0sirys/Juan_Pimentel_Electiva_2026_C2/CAD/Ejercicio_2.FCStd

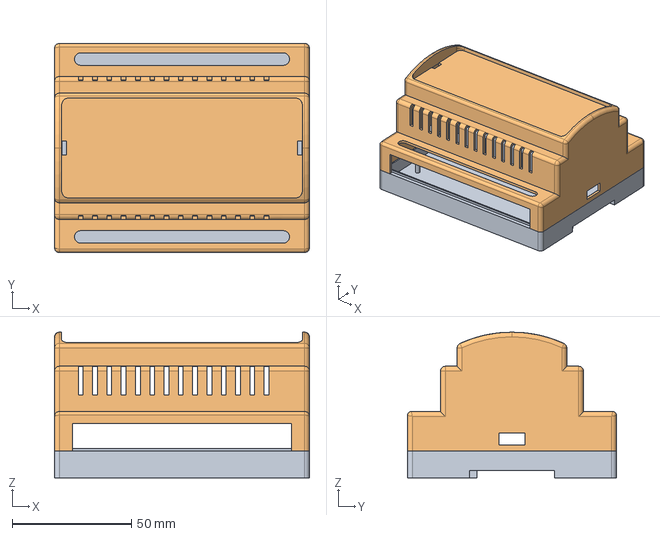
[picture p1: CAD file, 2026-06-18]
CAD/Ejercicio_2.FCStd
107.0 x 87.7 x 61.1 mm
