0sirys/Juan_Pimentel_Electiva_2026_C2/CAD/Ejercicio_1.FCStd

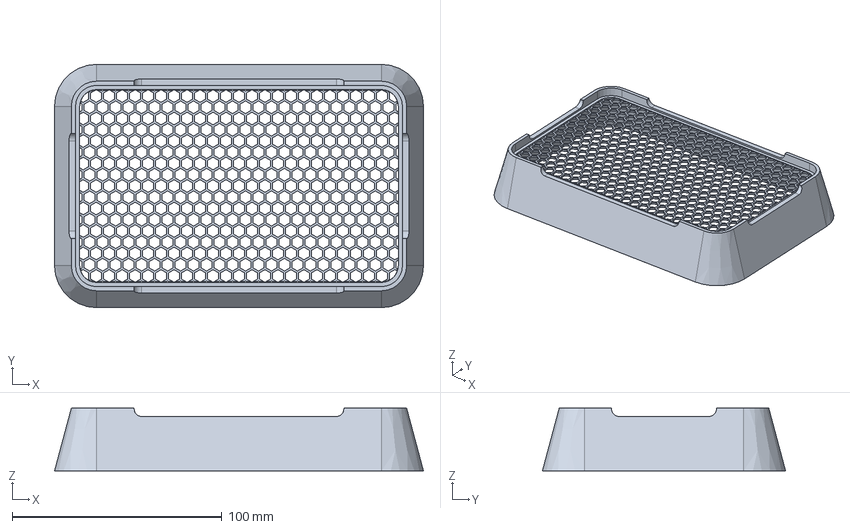
[picture p2: CAD file, 2026-06-11]
CAD/Ejercicio_1.FCStd
176.1 x 116.1 x 30.0 mm
