0sirys/Juan_Pimentel_Electiva_2026_C2/PCB/PLC4UNI/PLC4UNI-GC1.pdf

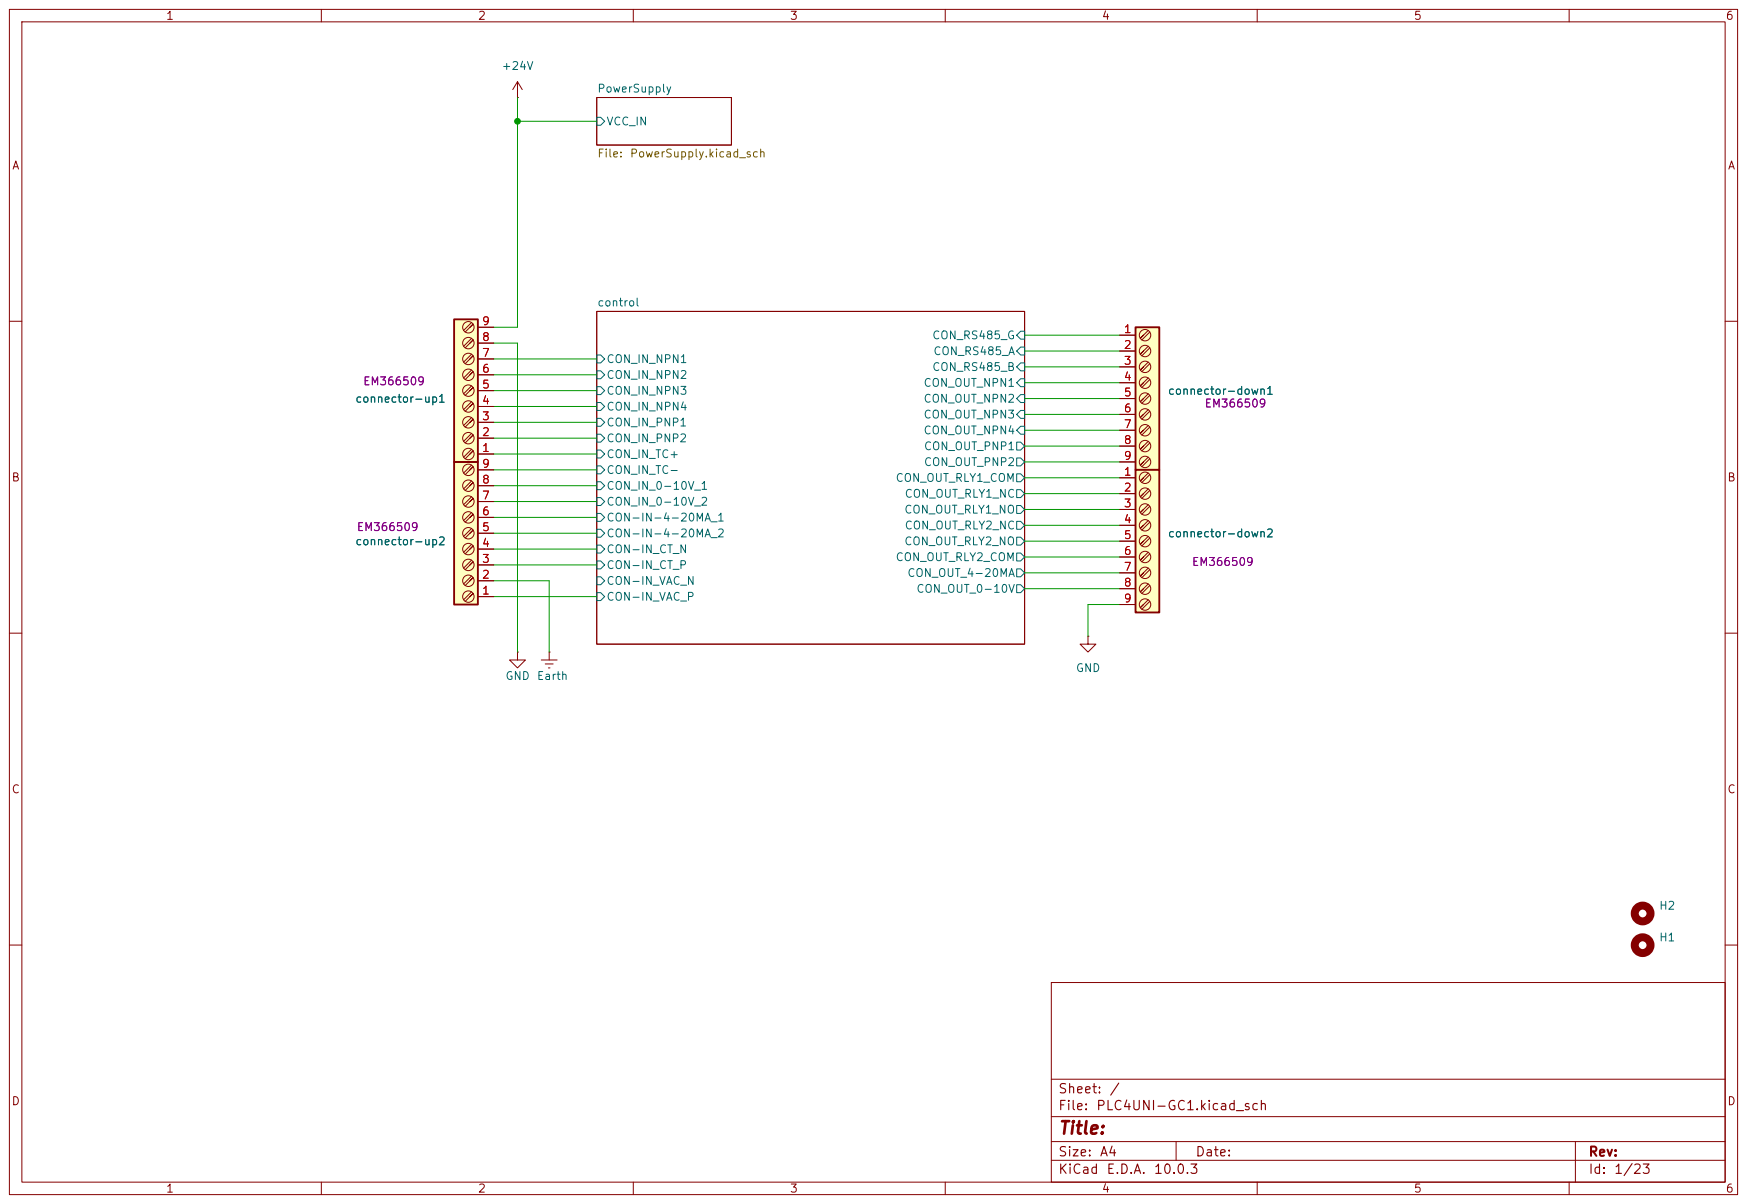
[picture p3: page 1]

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
Size: A4 | Rev:
KiCad E.D.A. 10.0.3 | Id: 1/23

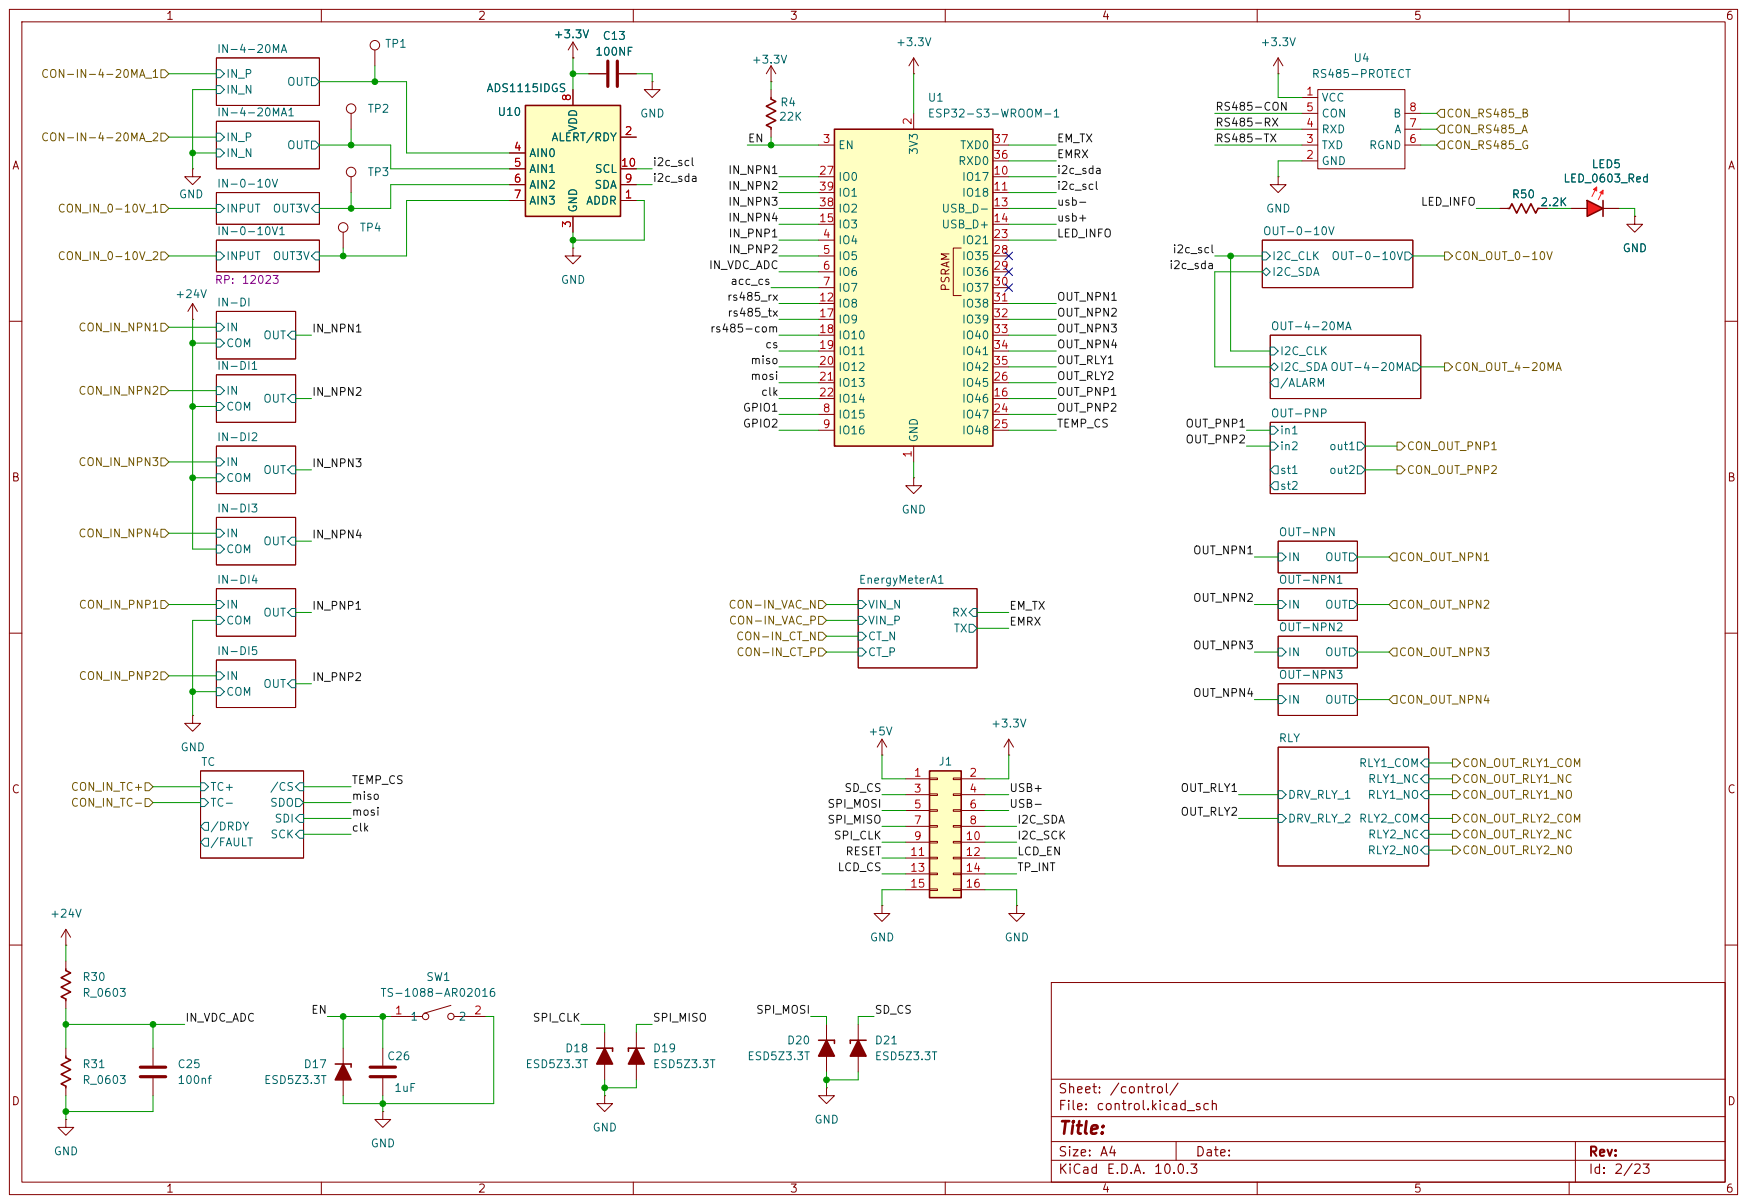
[picture p4: page 2]

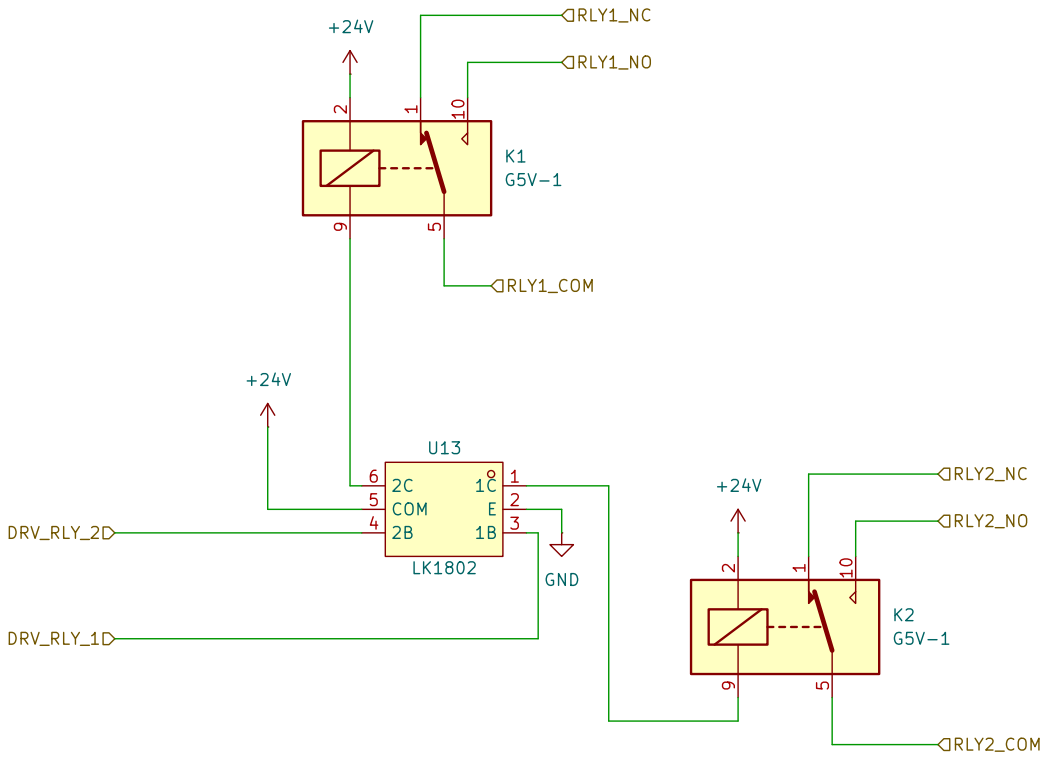
[picture p5: page 3]

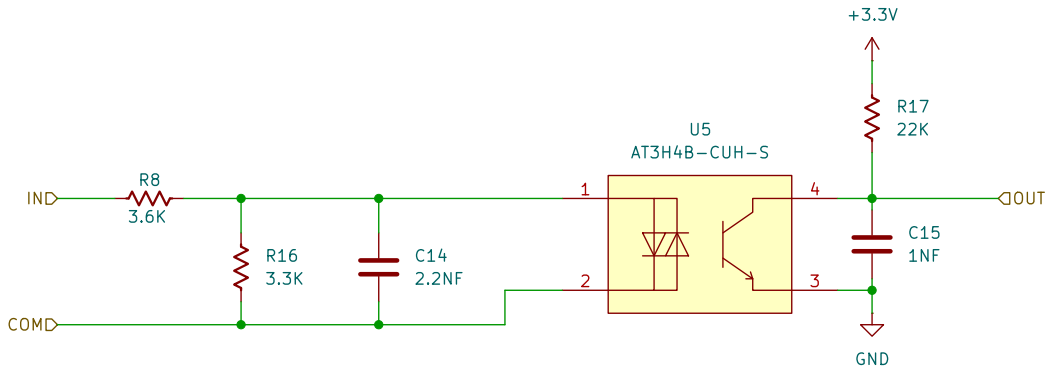
[picture p6: page 4]

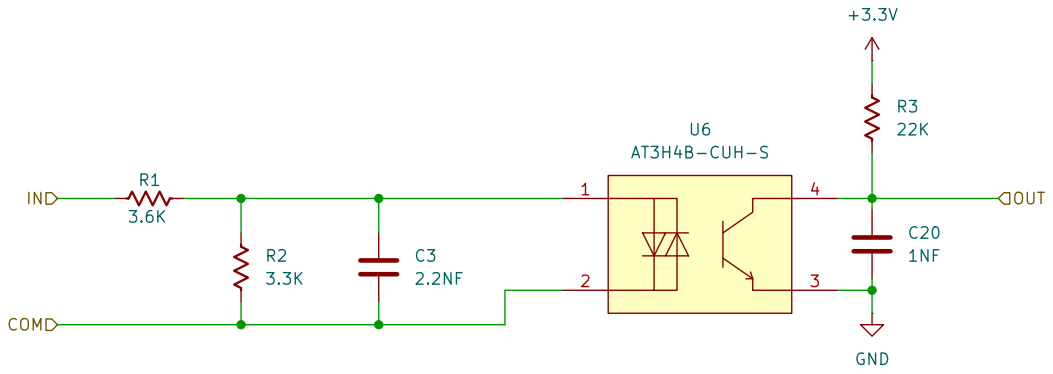
[picture p7: page 5]

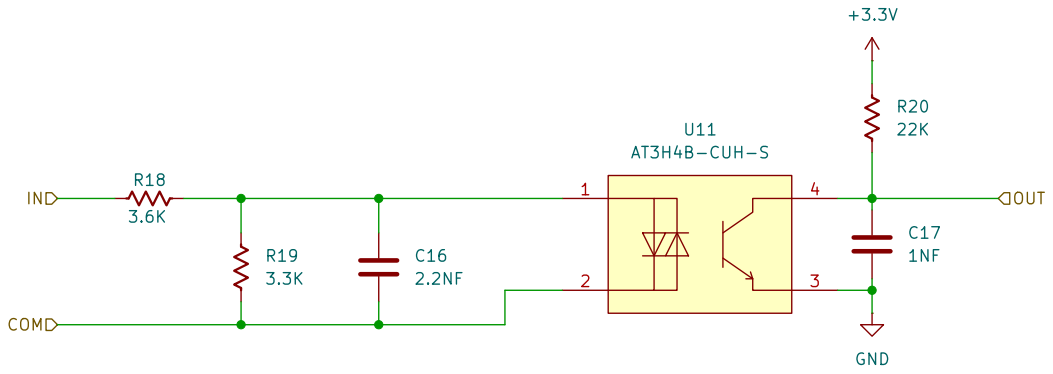
[picture p8: page 6]

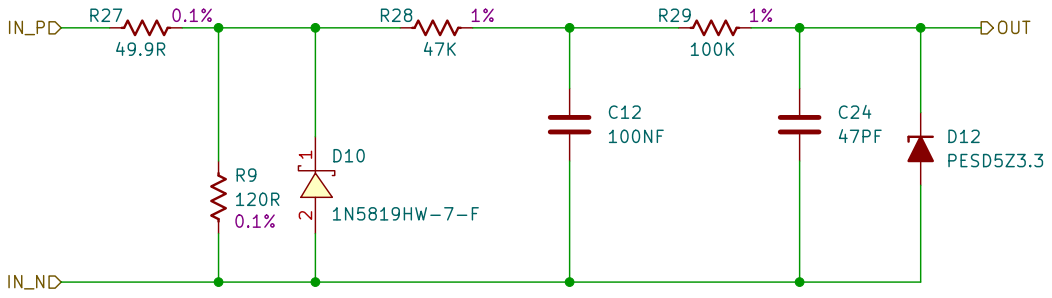
[picture p9: page 7]

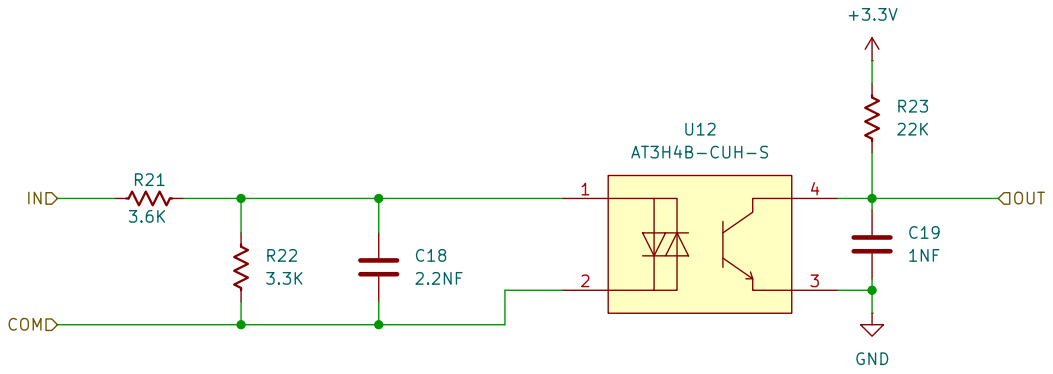
[picture p10: page 8]

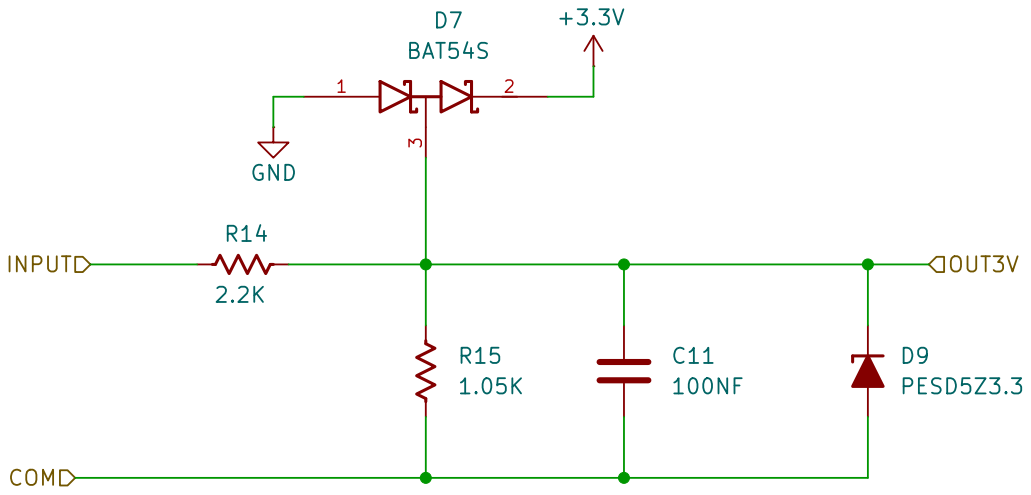
[picture p11: page 9]

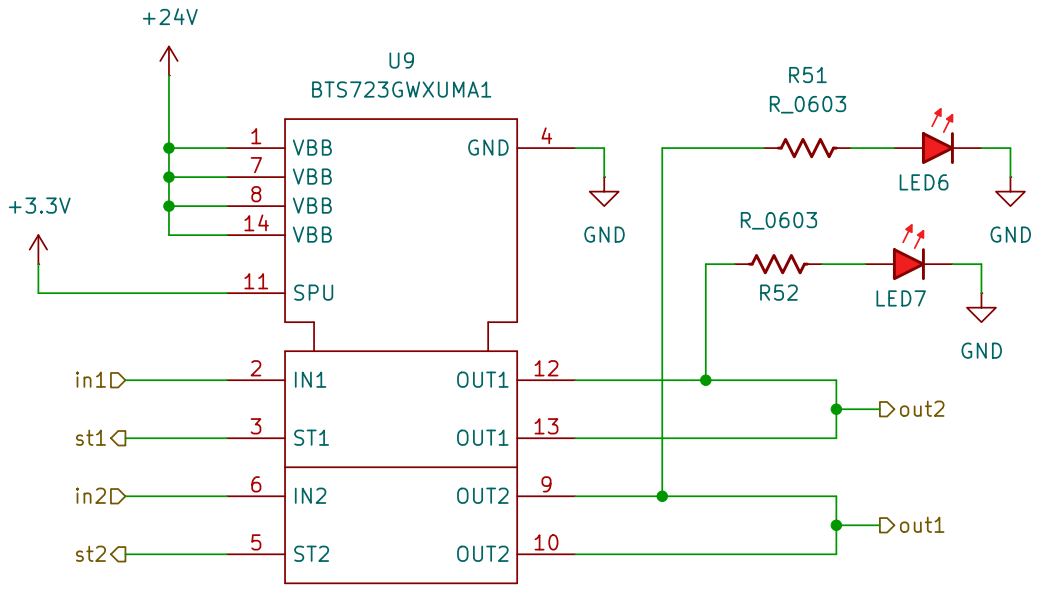
[picture p12: page 10]

Sheet: /control/OUT-PNP/
File: OUT-PNP.kicad_sch
Title:

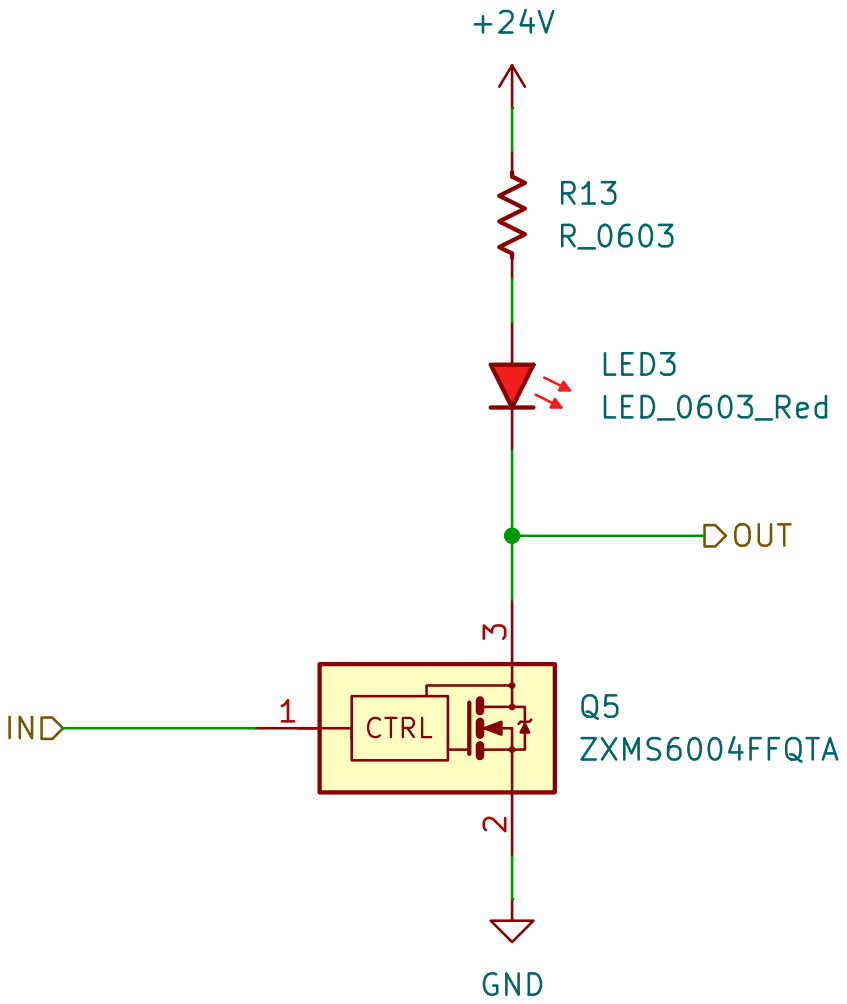
[picture p13: page 11]

Sheet: /control/OUT-NPN/
File: OUT-NPN.kicad_sch
Title:

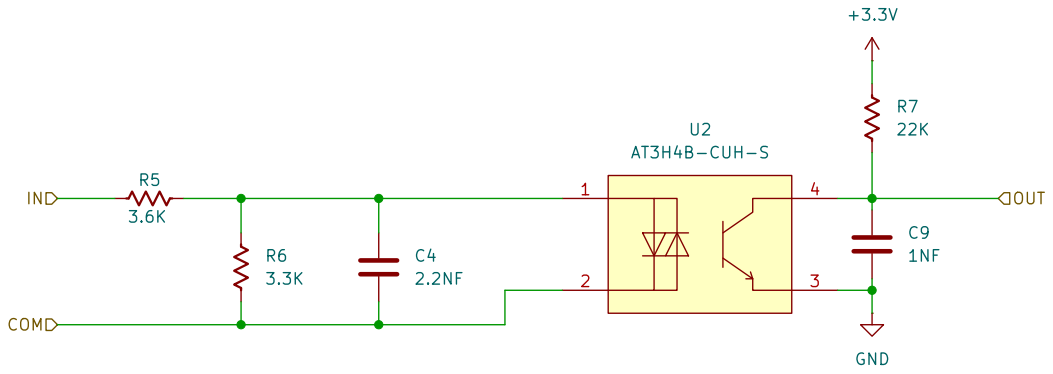
[picture p14: page 12]

Sheet: /control/IN-DI/
File: IN-DI.kicad_sch
Title:

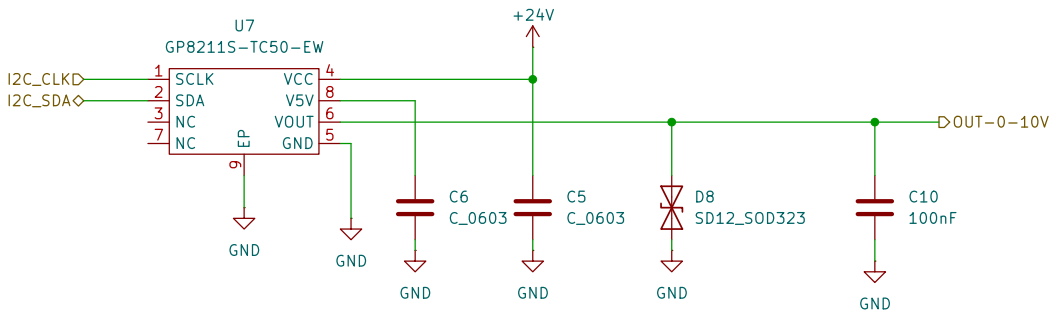
[picture p15: page 13]

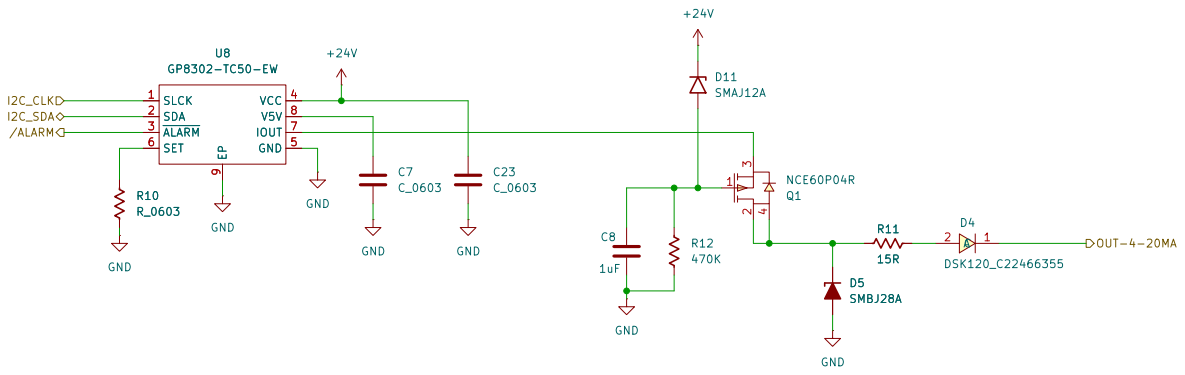
[picture p16: page 14]

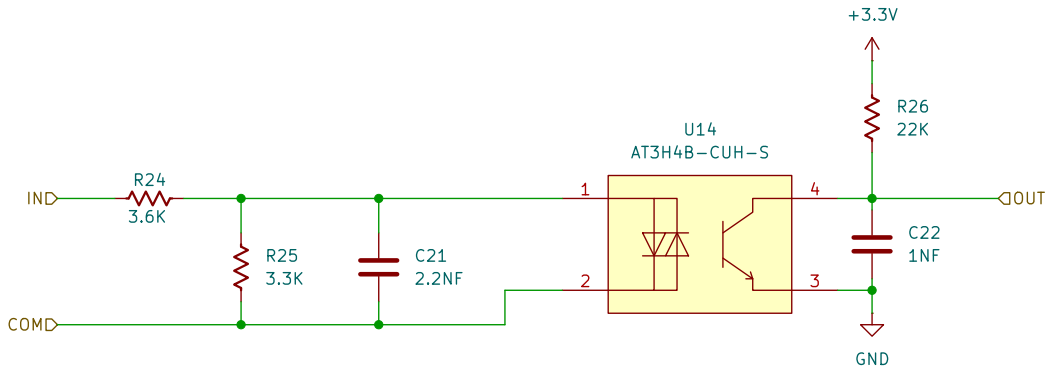
[picture p17: page 15]

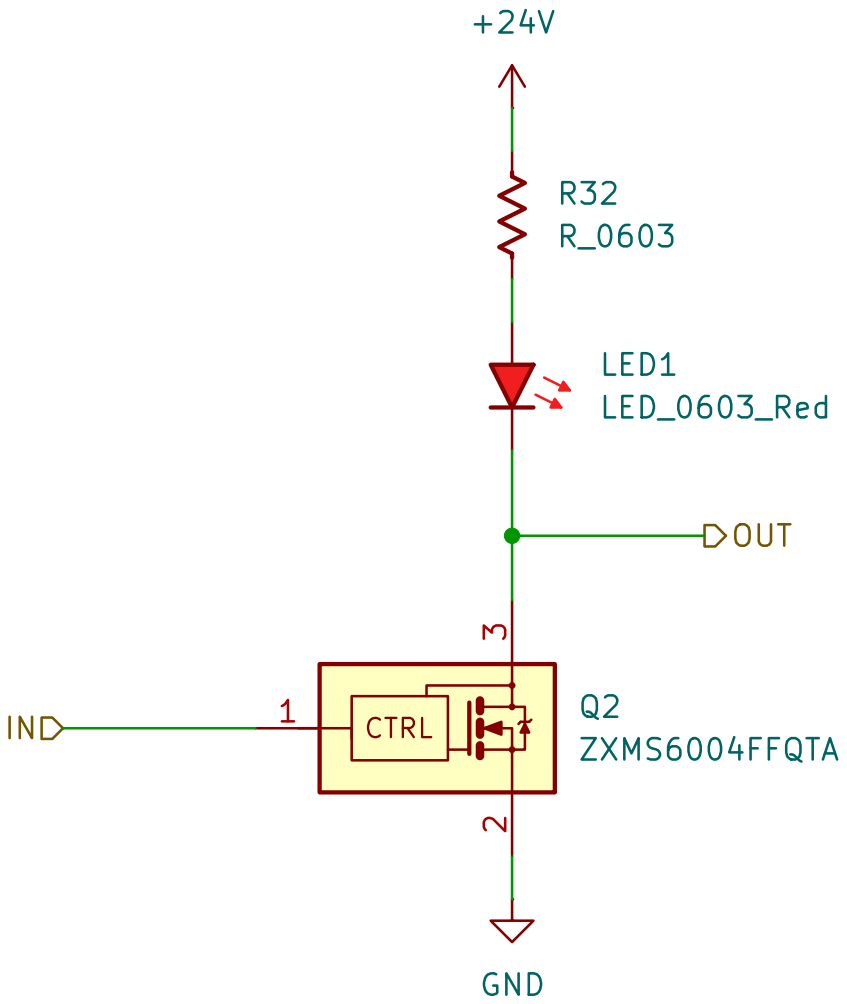
[picture p18: page 16]

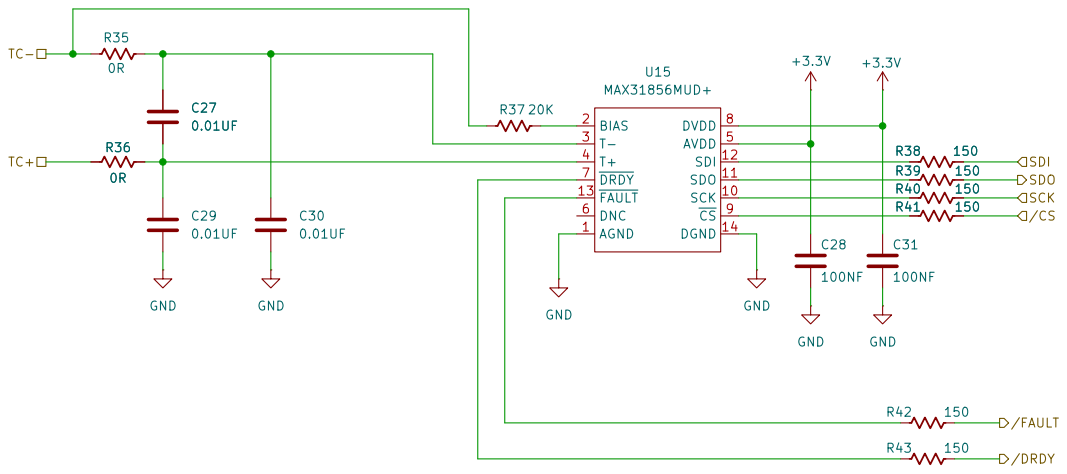
[picture p19: page 17]

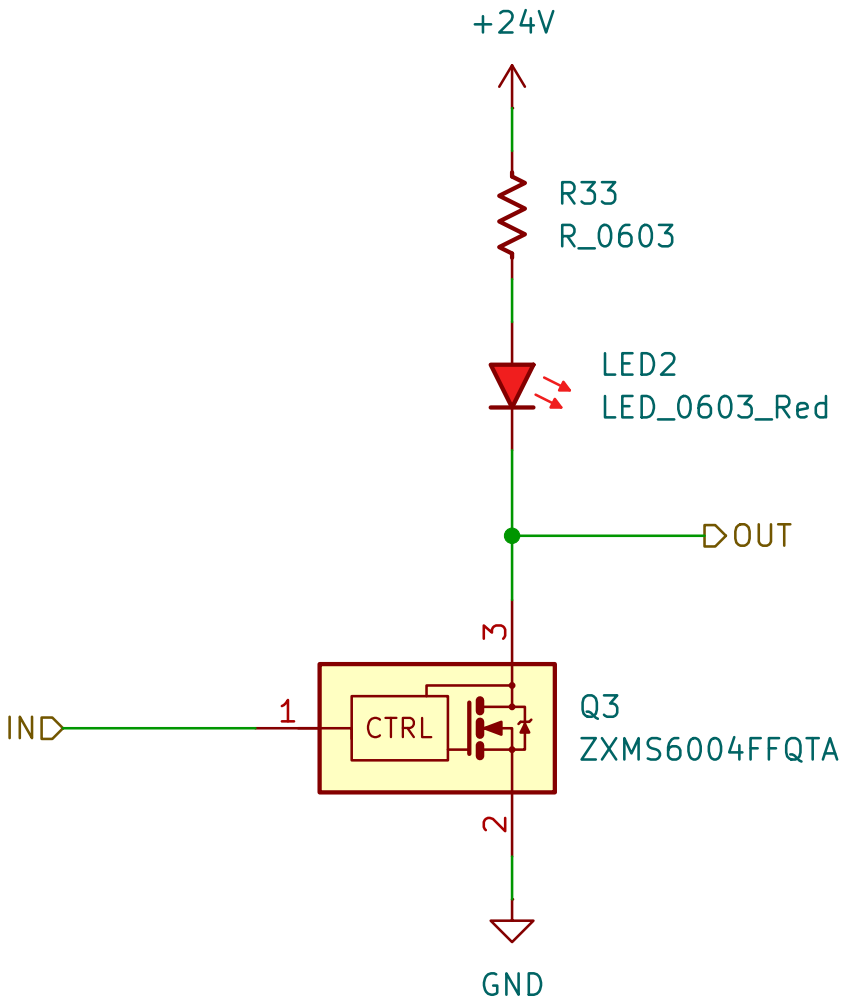
[picture p20: page 18]

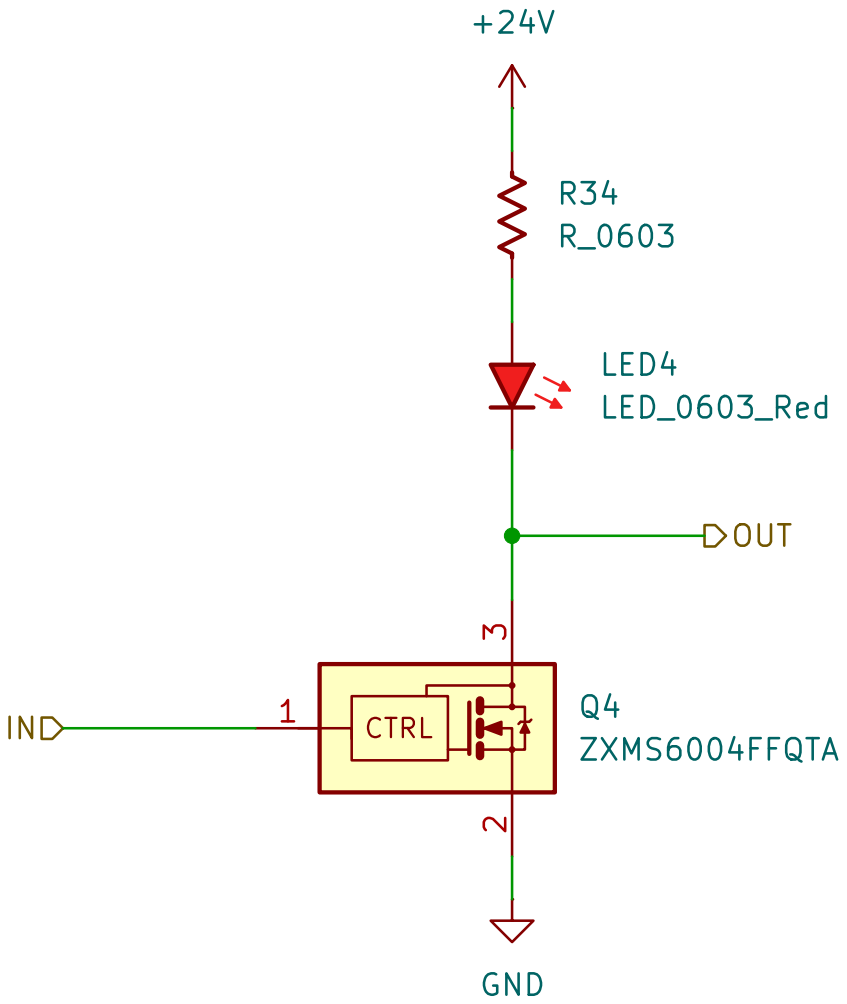
[picture p21: page 19]

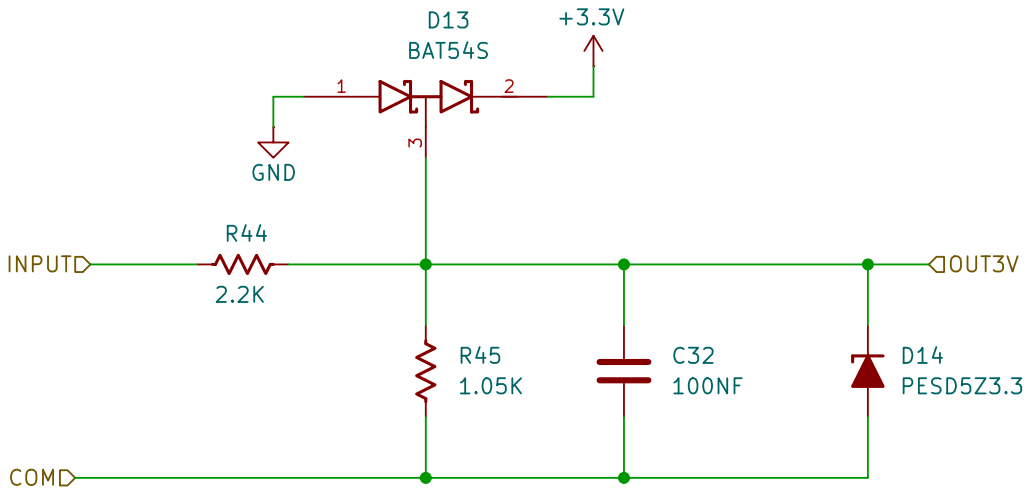
[picture p22: page 20]

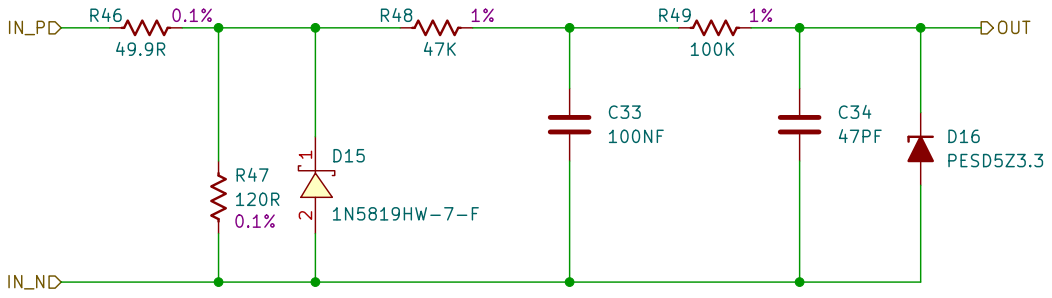
[picture p23: page 21]

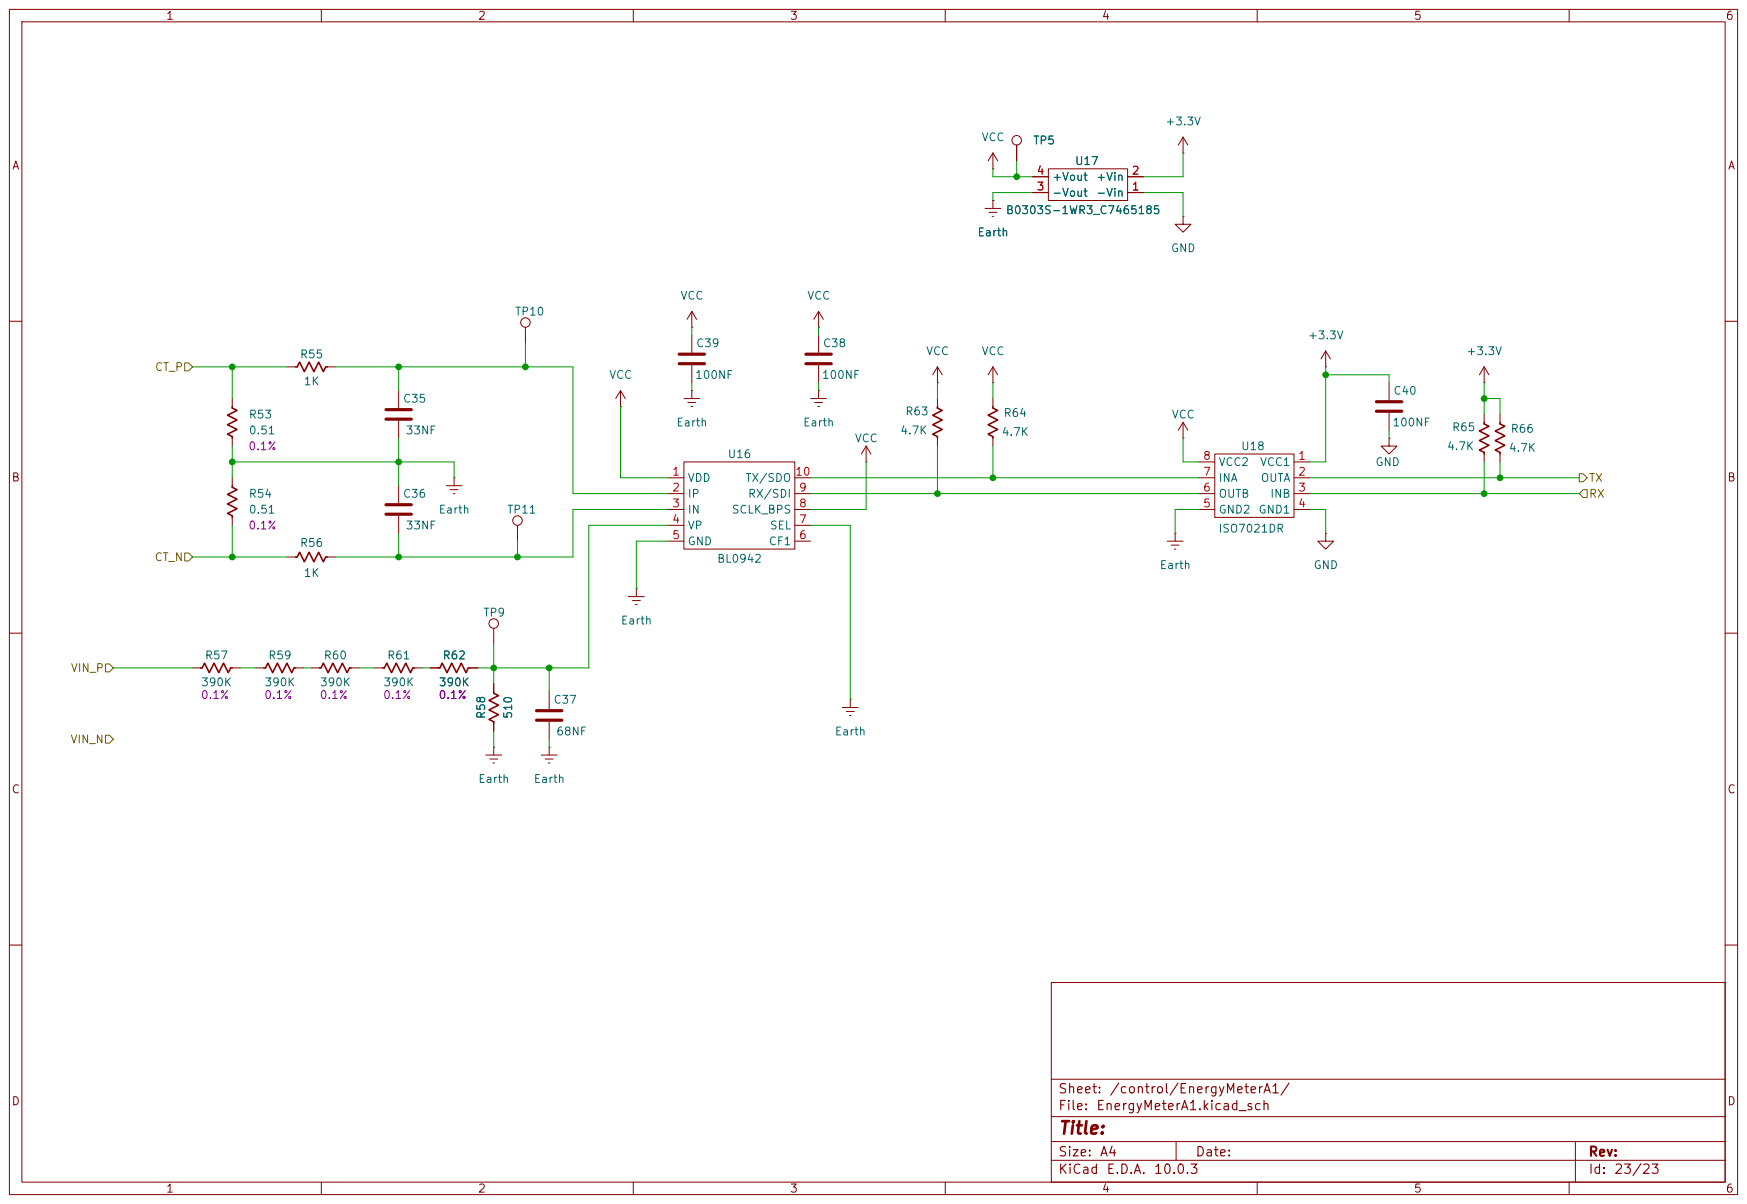
[picture p24: page 22]

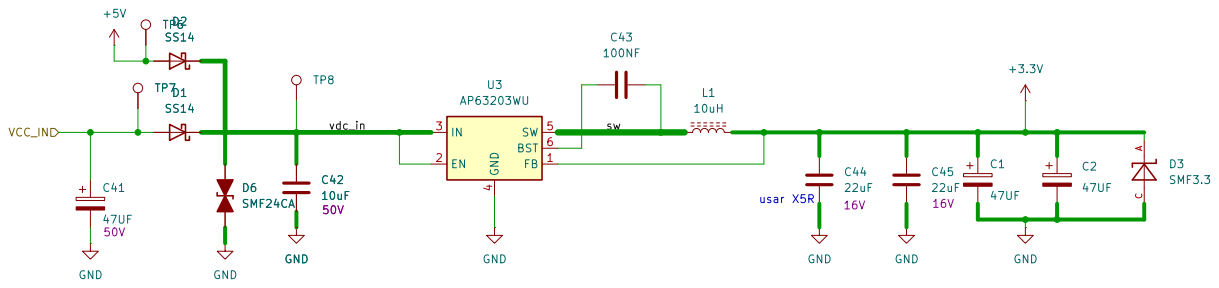
[picture p25: page 23]
