0sirys/Juan_Pimentel_Electiva_2026_C2/PCB/MEZANINI/PLC4UNI_MEZANINI/PLC4UNI_MEZANINI.kicad_pcb

## KiCad design PCB/MEZANINI/PLC4UNI_MEZANINI/PLC4UNI_MEZANINI.kicad_pcb (2026-08-13)

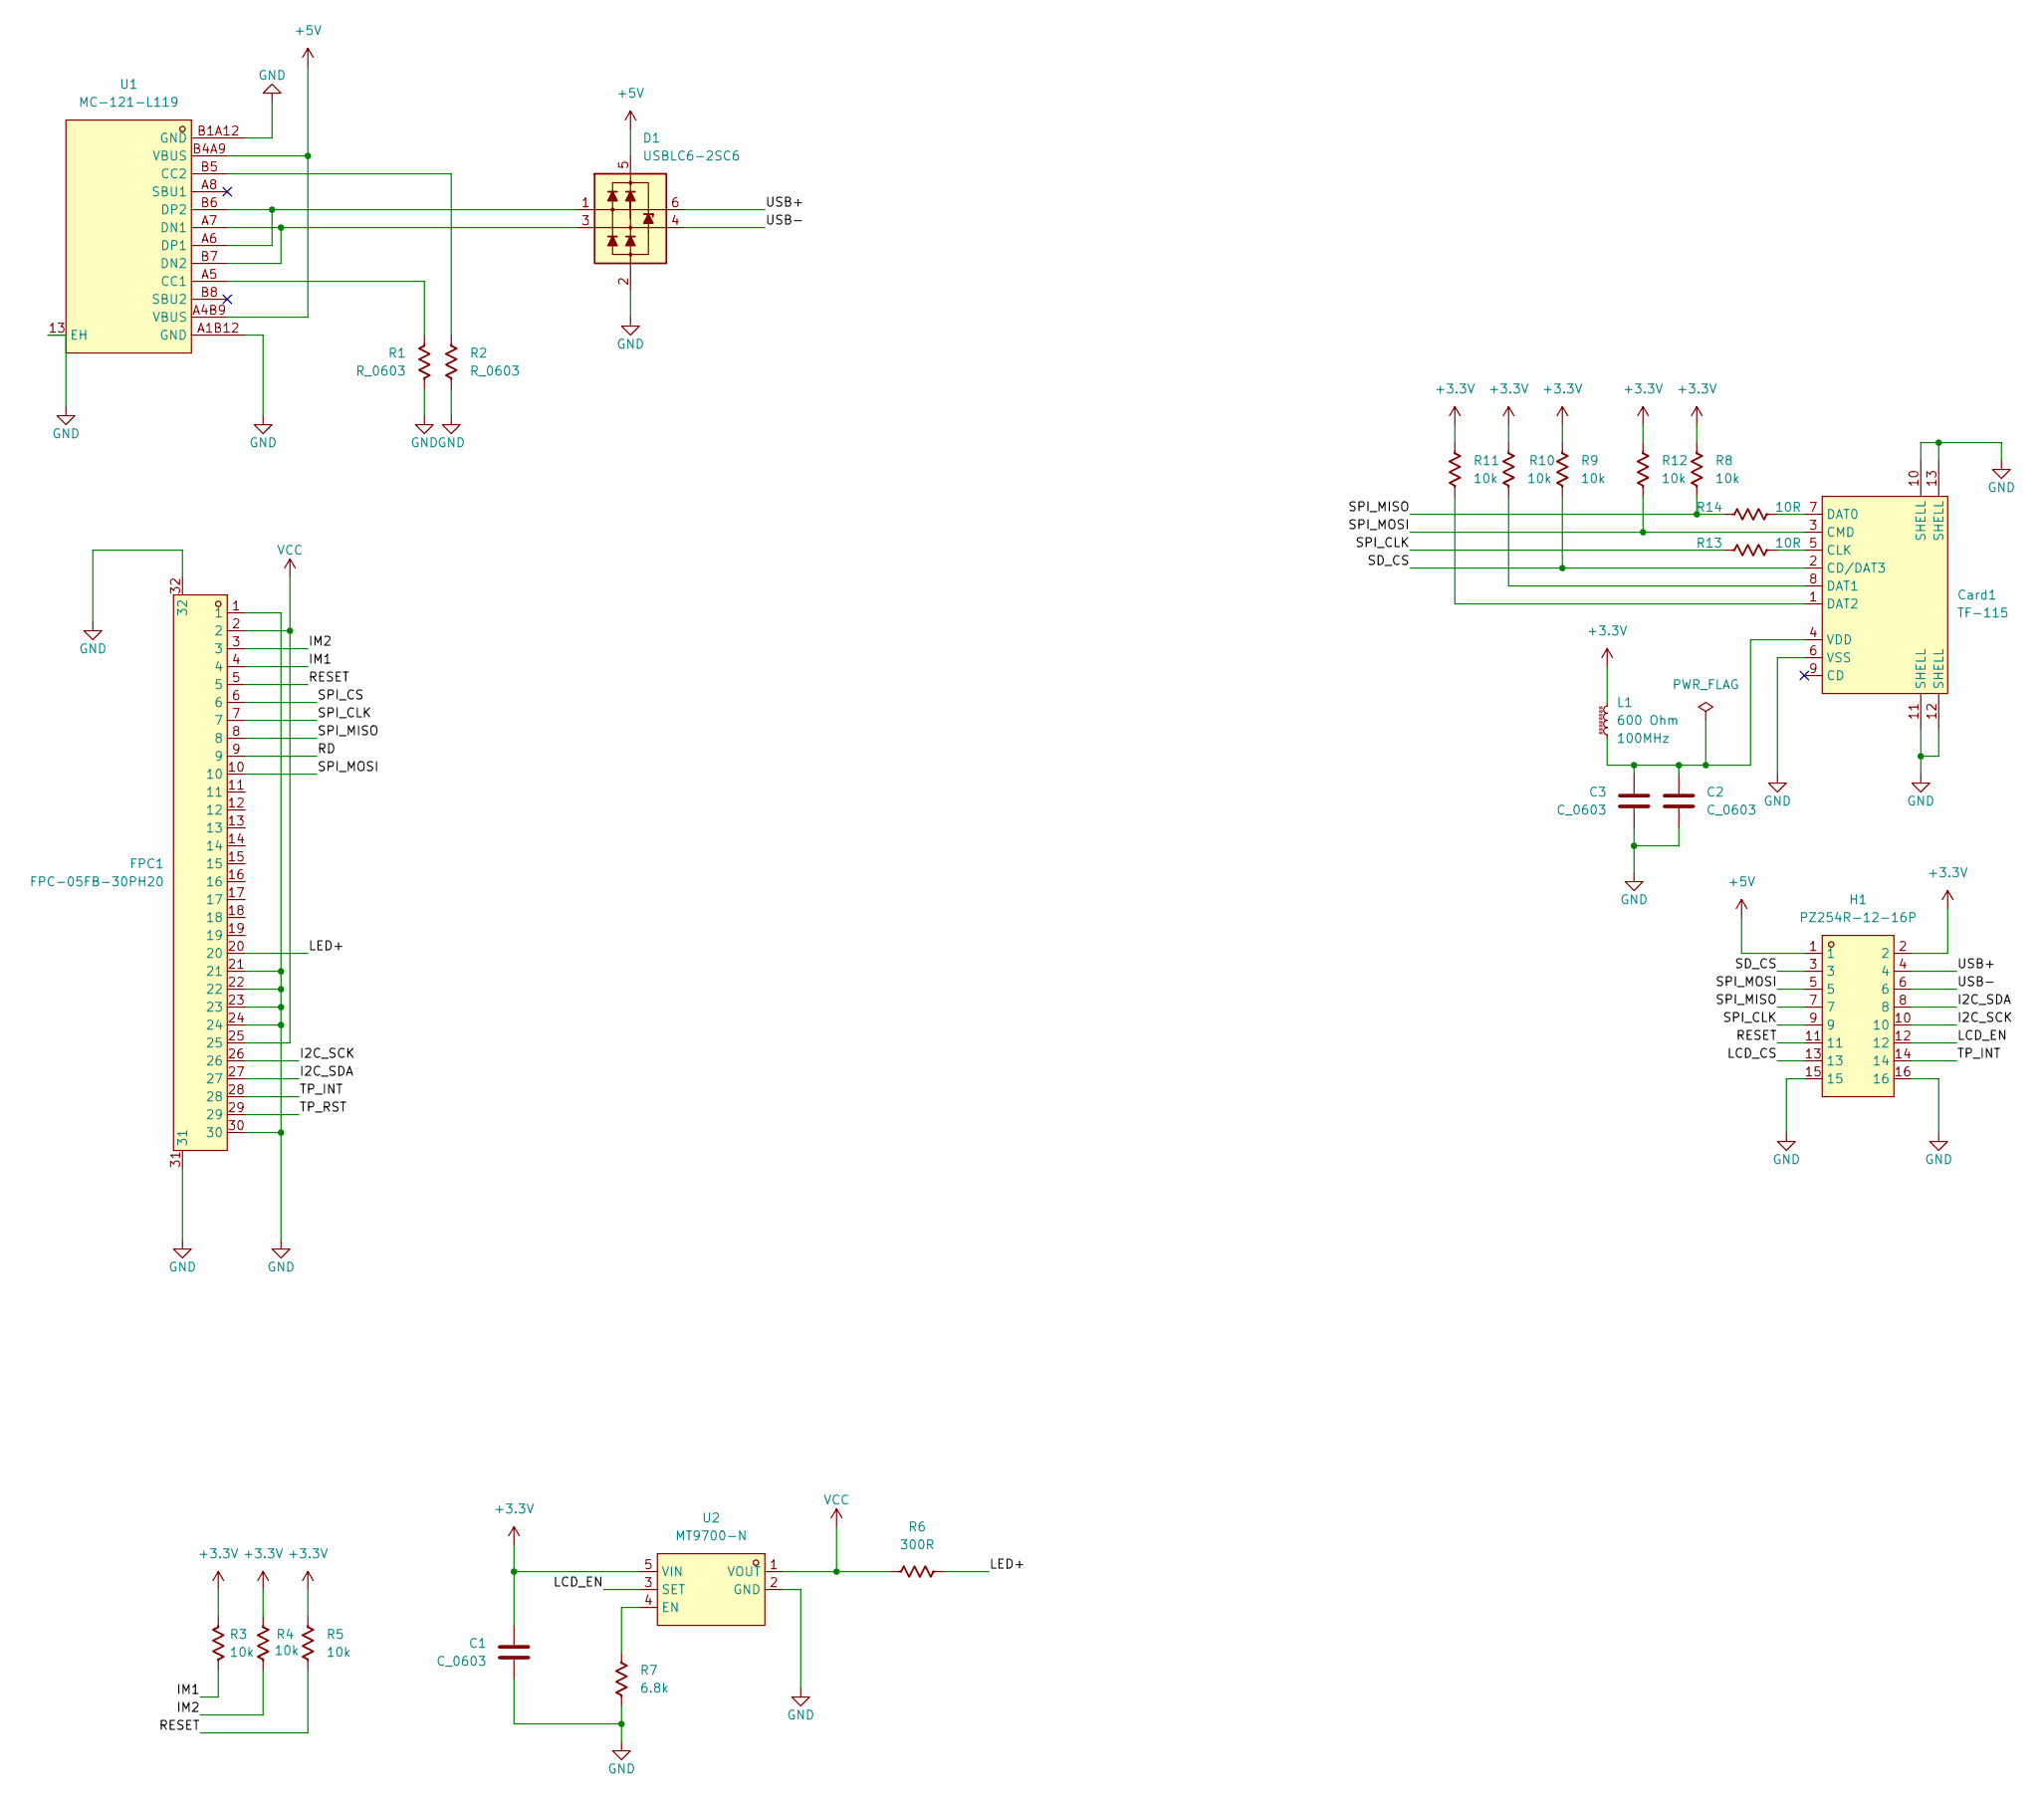
[picture p26: schematic PLC4UNI_MEZANINI.kicad_sch]

Parts:
C1, C2, C3: C_0603; C_0603_1608Metric
Card1: TF-115; TF-SMD_TF-115; MPN TF-115; LCSC Part C266620
D1: USBLC6-2SC6; SOT-23-6
FPC1: FPC-05FB-30PH20; FPC-SMD_30P-P0.50_FPC-05FB-30PH20; MPN FPC-05FB-30PH20; LCSC Part C2856833
H1: PZ254R-12-16P; HDR-TH_16P-P2.54-H-M-R2-C8-S2.54; MPN PZ254R-12-16P; LCSC Part C492436
L1: 600 Ohm; C_0805_2012Metric
R1, R2: R_0603; R_0603_1608Metric
R3, R4, R5, R8, R9, R10, R11, R12: 10k; R_0603_1608Metric
R6: 300R; R_0603_1608Metric
R7: 6.8k; R_0603_1608Metric
R13, R14: 10R; R_0603_1608Metric
U1: MC-121-L119; USB-C-SMD_HANBO_MC-121-L119; MPN MC-121-L119; LCSC Part C6332278
U2: MT9700-N; SOT-23-5_L2.9-W1.6-P0.95-LS2.9-BL; MPN MT9700-N; LCSC Part C42441843

Connections:
+3.3V: C1.1, H1.2, L1.2, R3.1, R4.1, R5.1, R8.1, R9.1, R10.1, R11.1, R12.1, U2.5 (VIN)
+5V: D1.5 (VP), H1.1, U1.A4B9 (VBUS), U1.B4A9 (VBUS)
/I2C_SCK: FPC1.26, H1.10
/I2C_SDA: FPC1.27, H1.8
/IM1: FPC1.4, R3.2
/IM2: FPC1.3, R4.2
/LCD_CS: H1.13
/LCD_EN: H1.12, U2.3 (SET)
/LED+: FPC1.20, R6.2
/RD: FPC1.9
/RESET: FPC1.5, H1.11, R5.2
/SD_CS: Card1.2 (CD/DAT3), H1.3, R9.2
/SPI_CLK: FPC1.7, H1.9, R13.1
/SPI_CS: FPC1.6
/SPI_MISO: FPC1.8, H1.7, R8.2, R14.1
/SPI_MOSI: Card1.3 (CMD), FPC1.10, H1.5, R12.2
/TP_INT: FPC1.28, H1.14
/TP_RST: FPC1.29
/USB+: D1.6 (L1), H1.4
/USB-: D1.4 (L2), H1.6
GND: C1.2, C2.2, C3.2, Card1.6 (VSS), Card1.10 (SHELL), Card1.11 (SHELL), Card1.12 (SHELL), Card1.13 (SHELL), D1.2 (VN), FPC1.1, FPC1.21, FPC1.22, FPC1.23, FPC1.24, FPC1.30, FPC1.31, FPC1.32, H1.15, H1.16, R1.2, R2.2, R7.1, U1.13 (EH), U1.A1B12 (GND), U1.B1A12 (GND), U2.2 (GND)
unnamed: Card1.5 (CLK), R13.2
unnamed: Card1.7 (DAT0), R14.2
unnamed: Card1.8 (DAT1), R10.2
unnamed: Card1.1 (DAT2), R11.2
unnamed: C2.1, C3.1, Card1.4 (VDD), L1.1
unnamed: R1.1, U1.A5 (CC1)
unnamed: R2.1, U1.B5 (CC2)
unnamed: D1.3 (L2), U1.A7 (DN1), U1.B7 (DN2)
unnamed: D1.1 (L1), U1.A6 (DP1), U1.B6 (DP2)
unnamed: R7.2, U2.4 (EN)
VCC: FPC1.2, FPC1.25, R6.1, U2.1 (VOUT)

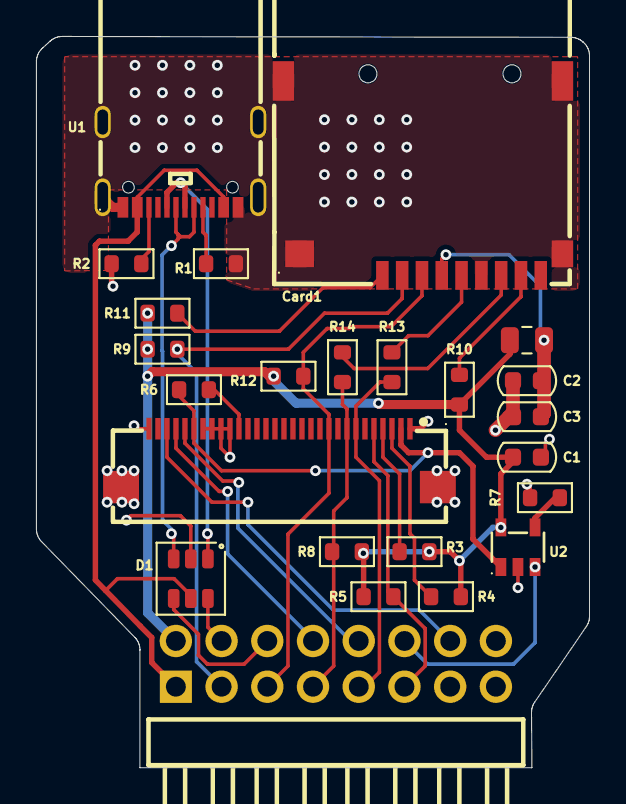
[picture p27: board PLC4UNI_MEZANINI.kicad_pcb from above]

Board: 2 copper layers, 30.7 x 40.6 mm, 24 parts (0 on the bottom side), 28 nets.
