0sirys/Juan_Pimentel_Electiva_2026_C2/PCB/PLC4UNI/_restore_backup_2026-08-12T22-09-03-060/PLC4UNI.kicad_pcb

## KiCad design PCB/PLC4UNI/_restore_backup_2026-08-12T22-09-03-060/PLC4UNI.kicad_pcb (2026-08-13)

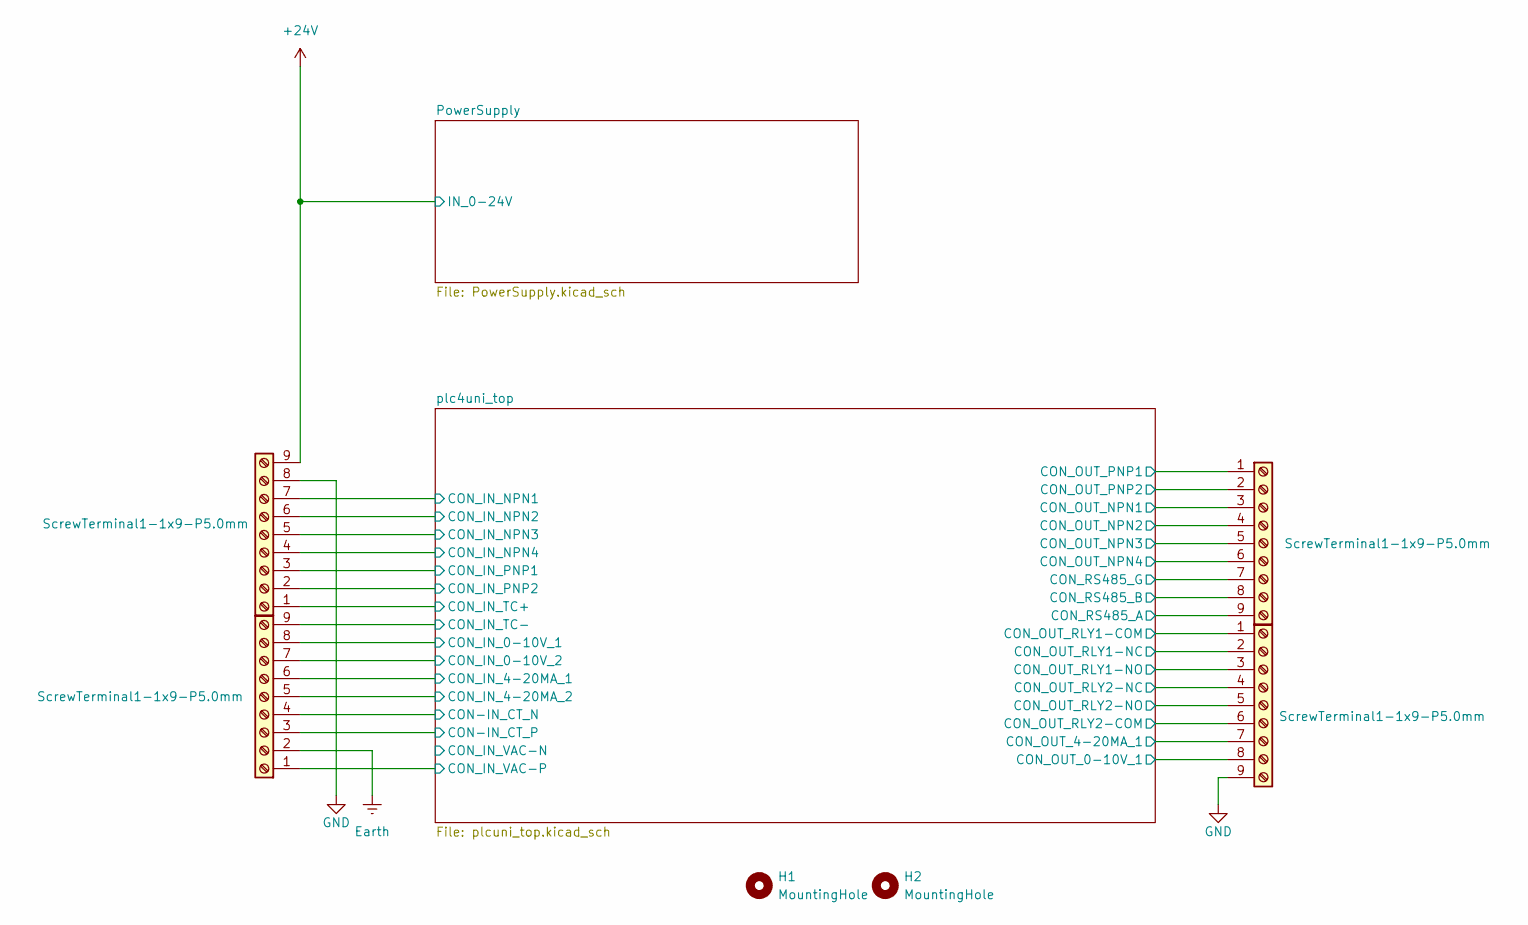
[picture p28: schematic PLC4UNI.kicad_sch]

Parts:
H1, H2: MountingHole; MountingHole_2.2mm_M2_DIN965
U1, U2, U3, U4: ScrewTerminal1-1x9-P5.0mm; CONN-TH_9P-P5.00_DB127V-5.0-9P-GN-S; MPN DB127V-5.0-9P-GN-S; LCSC Part C430627

Connections:
+24V: U1.9; also elsewhere on the board
/plc4uni_top/CON-IN_CT_N: U2.4; also elsewhere on the board
/plc4uni_top/CON-IN_CT_P: U2.3; also elsewhere on the board
/plc4uni_top/CON_IN_0-10V_1: U2.8; also elsewhere on the board
/plc4uni_top/CON_IN_0-10V_2: U2.7; also elsewhere on the board
/plc4uni_top/CON_IN_4-20MA_1: U2.6; also elsewhere on the board
/plc4uni_top/CON_IN_4-20MA_2: U2.5; also elsewhere on the board
/plc4uni_top/CON_IN_NPN1: U1.7; also elsewhere on the board
/plc4uni_top/CON_IN_NPN2: U1.6; also elsewhere on the board
/plc4uni_top/CON_IN_NPN3: U1.5; also elsewhere on the board
/plc4uni_top/CON_IN_NPN4: U1.4; also elsewhere on the board
/plc4uni_top/CON_IN_PNP1: U1.3; also elsewhere on the board
/plc4uni_top/CON_IN_PNP2: U1.2; also elsewhere on the board
/plc4uni_top/CON_IN_TC+: U1.1; also elsewhere on the board
/plc4uni_top/CON_IN_TC-: U2.9; also elsewhere on the board
/plc4uni_top/CON_IN_VAC-P: U2.1; also elsewhere on the board
/plc4uni_top/CON_OUT_0-10V_1: U4.8; also elsewhere on the board
/plc4uni_top/CON_OUT_4-20MA_1: U4.7; also elsewhere on the board
/plc4uni_top/CON_OUT_NPN1: U3.3; also elsewhere on the board
/plc4uni_top/CON_OUT_NPN2: U3.4; also elsewhere on the board
/plc4uni_top/CON_OUT_NPN3: U3.5; also elsewhere on the board
/plc4uni_top/CON_OUT_NPN4: U3.6; also elsewhere on the board
/plc4uni_top/CON_OUT_PNP1: U3.1; also elsewhere on the board
/plc4uni_top/CON_OUT_PNP2: U3.2; also elsewhere on the board
/plc4uni_top/CON_OUT_RLY1-COM: U4.1; also elsewhere on the board
/plc4uni_top/CON_OUT_RLY1-NC: U4.2; also elsewhere on the board
/plc4uni_top/CON_OUT_RLY1-NO: U4.3; also elsewhere on the board
/plc4uni_top/CON_OUT_RLY2-COM: U4.6; also elsewhere on the board
/plc4uni_top/CON_OUT_RLY2-NC: U4.4; also elsewhere on the board
/plc4uni_top/CON_OUT_RLY2-NO: U4.5; also elsewhere on the board
/plc4uni_top/CON_RS485_A: U3.9; also elsewhere on the board
/plc4uni_top/CON_RS485_B: U3.8; also elsewhere on the board
/plc4uni_top/CON_RS485_G: U3.7; also elsewhere on the board
Earth: U2.2; also elsewhere on the board
GND: U1.8, U4.9; also elsewhere on the board

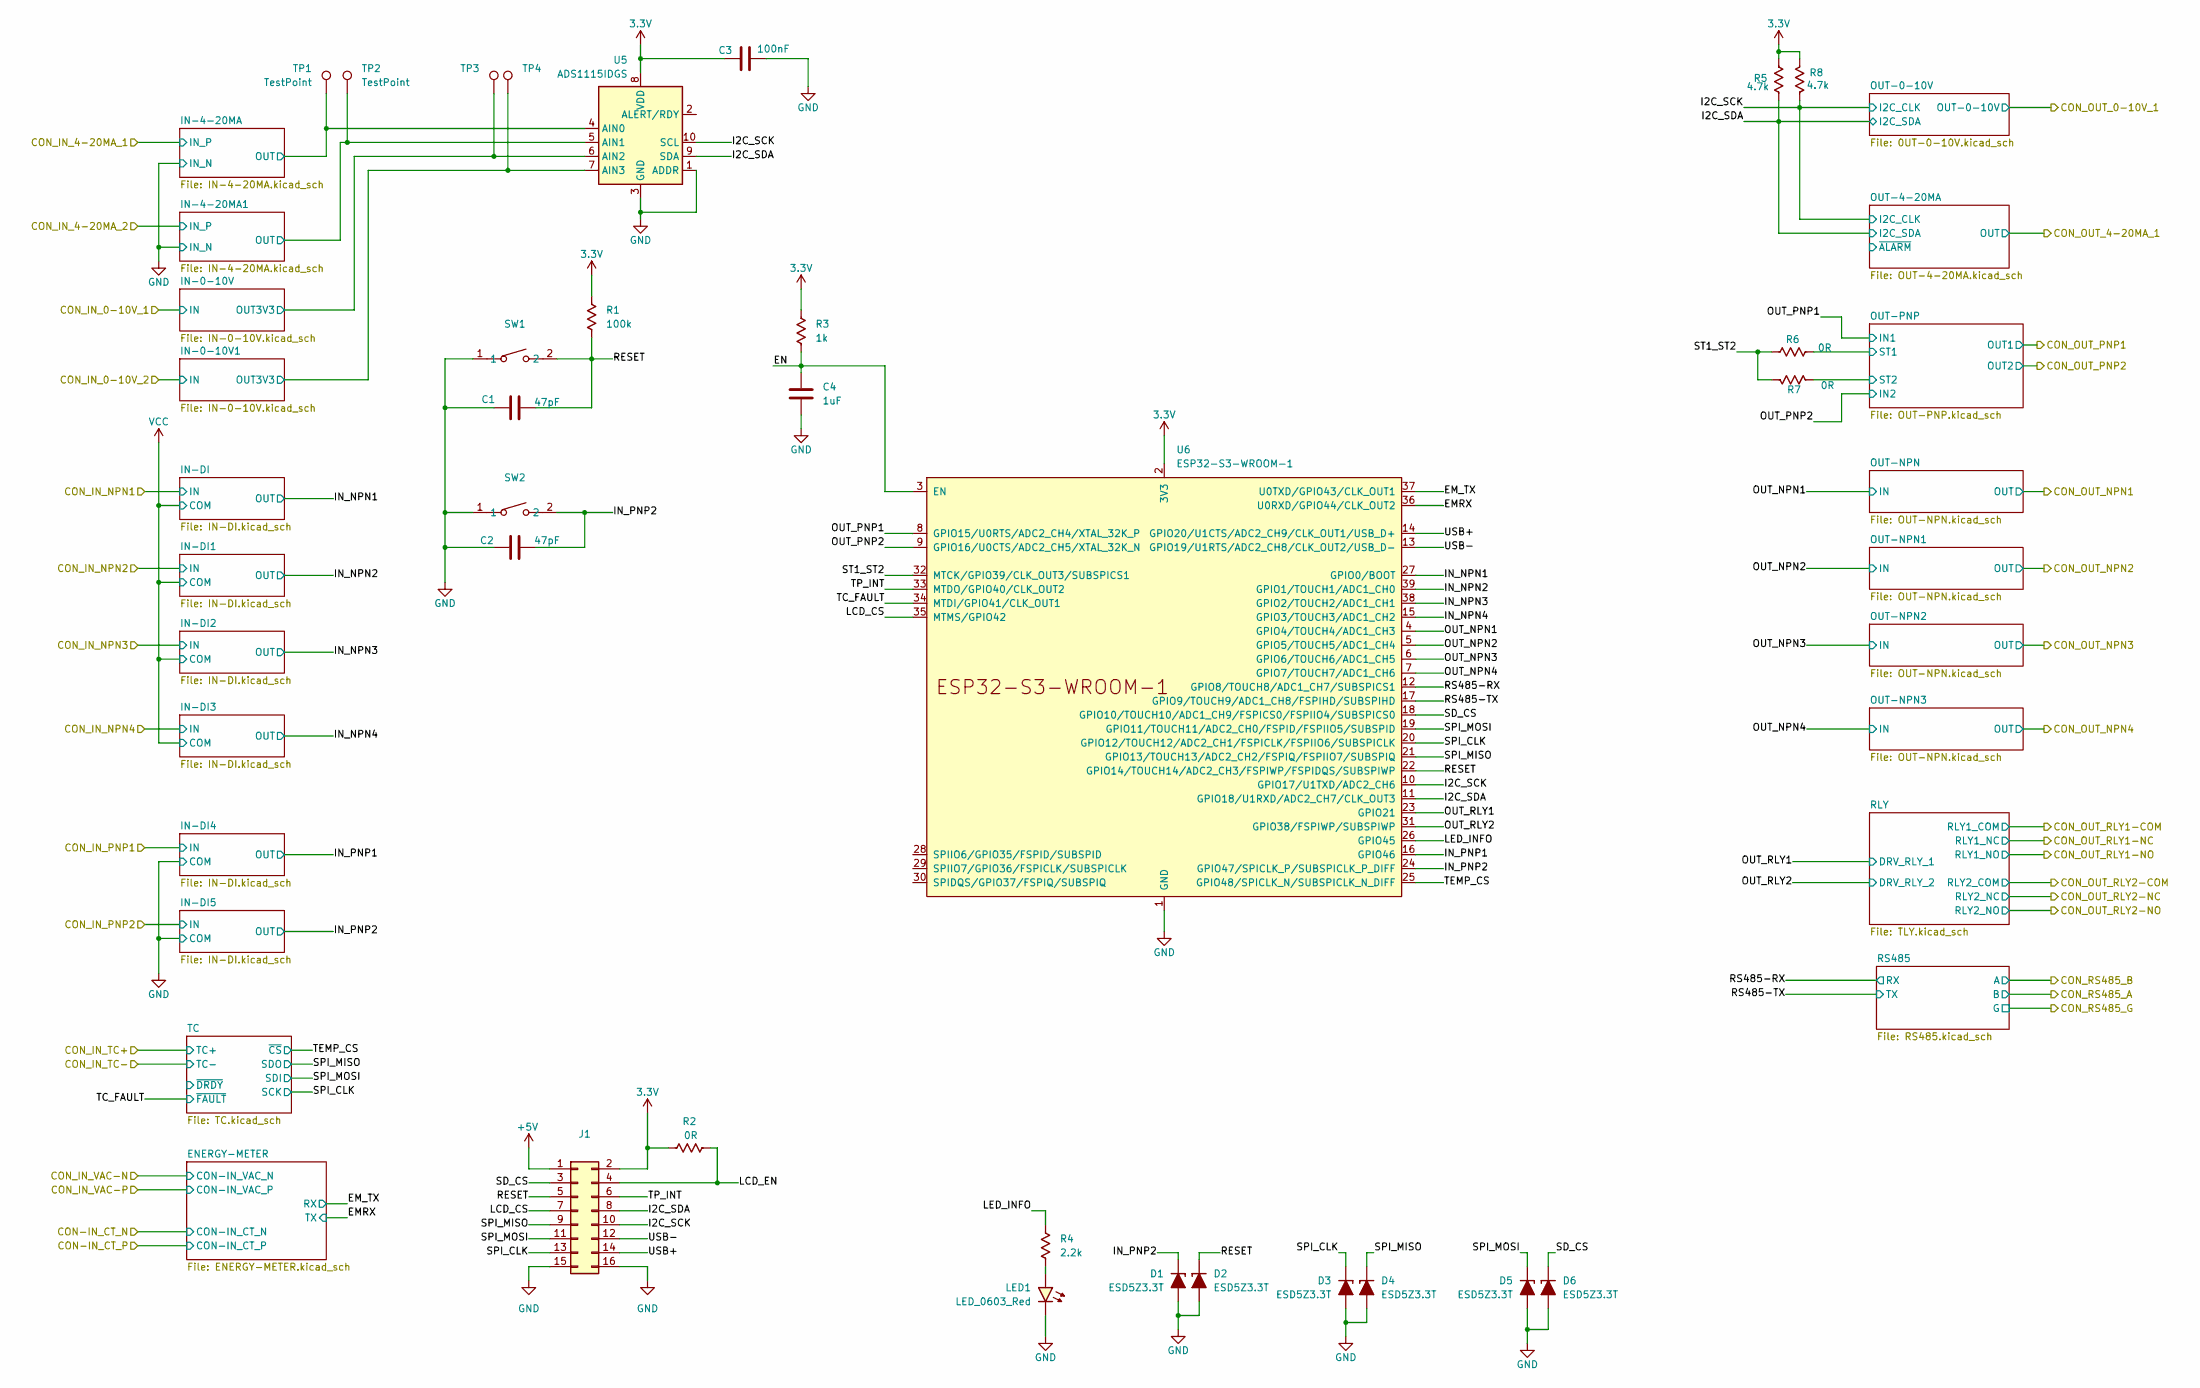
[picture p29: schematic plcuni_top.kicad_sch]

Parts:
C1, C2: 47pF; C_0603_1608Metric
C3: 100nF; C_0603_1608Metric
C4: 1uF; C_0603_1608Metric
D1, D2, D3, D4, D5, D6: ESD5Z3.3T; D_SOD-523
J1: Conn_02x08_Odd_Even; PinHeader_2x08_P2.54mm_Vertical
LED1: LED_0603_Red; LED_0603_1608Metric
R1: 100k; R_0603_1608Metric
R2, R6, R7: 0R; R_0603_1608Metric
R3: 1k; R_0603_1608Metric
R4: 2.2k; R_0603_1608Metric
R5, R8: 4.7k; R_0603_1608Metric
SW1, SW2: TS-1088-AR02016; SW-SMD_L3.9-W3.0-P4.45; MPN TS-1088-AR02016; LCSC Part C720477
TP1, TP2, TP3, TP4: TestPoint; TestPoint_THTPad_D1.5mm_Drill0.7mm
U5: ADS1115IDGS; TSSOP-10_3x3mm_P0.5mm
U6: ESP32-S3-WROOM-1; ESP32-S3-WROOM-1U

Connections:
3.3V: C3.1, J1.2, R1.1, R2.1, R3.1, R5.2, R8.2, U5.8 (VDD), U6.2 (3V3); also elsewhere on the board
+5V: J1.1; also elsewhere on the board
/plc4uni_top/EMRX: U6.36 (U0RXD/GPIO44/CLK_OUT2); also elsewhere on the board
/plc4uni_top/EM_TX: U6.37 (U0TXD/GPIO43/CLK_OUT1); also elsewhere on the board
/plc4uni_top/EN: C4.1, R3.2, U6.3 (EN)
/plc4uni_top/I2C_SCK: J1.10, R8.1, U5.10 (SCL), U6.10 (GPIO17/U1TXD/ADC2_CH6); also elsewhere on the board
/plc4uni_top/I2C_SDA: J1.8, R5.1, U5.9 (SDA), U6.11 (GPIO18/U1RXD/ADC2_CH7/CLK_OUT3); also elsewhere on the board
/plc4uni_top/IN-0-10V1/OUT3V3: TP4.1 (1_1), U5.7 (AIN3); also elsewhere on the board
/plc4uni_top/IN-0-10V/OUT3V3: TP3.1 (1_1), U5.6 (AIN2); also elsewhere on the board
/plc4uni_top/IN-4-20MA1/OUT: TP2.1 (1_1), U5.5 (AIN1); also elsewhere on the board
/plc4uni_top/IN-4-20MA/OUT: TP1.1 (1_1), U5.4 (AIN0); also elsewhere on the board
/plc4uni_top/IN_NPN1: U6.27 (GPIO0/BOOT); also elsewhere on the board
/plc4uni_top/IN_NPN2: U6.39 (GPIO1/TOUCH1/ADC1_CH0); also elsewhere on the board
/plc4uni_top/IN_NPN3: U6.38 (GPIO2/TOUCH2/ADC1_CH1); also elsewhere on the board
/plc4uni_top/IN_NPN4: U6.15 (GPIO3/TOUCH3/ADC1_CH2); also elsewhere on the board
/plc4uni_top/IN_PNP1: U6.16 (GPIO46); also elsewhere on the board
/plc4uni_top/IN_PNP2: C2.1, D1.1 (K), SW2.2, U6.24 (GPIO47/SPICLK_P/SUBSPICLK_P_DIFF); also elsewhere on the board
/plc4uni_top/LCD_CS: J1.7, U6.35 (MTMS/GPIO42)
/plc4uni_top/LCD_EN: J1.4, R2.2
/plc4uni_top/LED_INFO: R4.1, U6.26 (GPIO45)
/plc4uni_top/OUT-PNP/ST1: R6.2; also elsewhere on the board
/plc4uni_top/OUT-PNP/ST2: R7.2; also elsewhere on the board
/plc4uni_top/OUT_NPN1: U6.4 (GPIO4/TOUCH4/ADC1_CH3); also elsewhere on the board
/plc4uni_top/OUT_NPN2: U6.5 (GPIO5/TOUCH5/ADC1_CH4); also elsewhere on the board
/plc4uni_top/OUT_NPN3: U6.6 (GPIO6/TOUCH6/ADC1_CH5); also elsewhere on the board
/plc4uni_top/OUT_NPN4: U6.7 (GPIO7/TOUCH7/ADC1_CH6); also elsewhere on the board
/plc4uni_top/OUT_PNP1: U6.8 (GPIO15/U0RTS/ADC2_CH4/XTAL_32K_P); also elsewhere on the board
/plc4uni_top/OUT_PNP2: U6.9 (GPIO16/U0CTS/ADC2_CH5/XTAL_32K_N); also elsewhere on the board
/plc4uni_top/OUT_RLY1: U6.23 (GPIO21); also elsewhere on the board
/plc4uni_top/OUT_RLY2: U6.31 (GPIO38/FSPIWP/SUBSPIWP); also elsewhere on the board
/plc4uni_top/RESET: C1.1, D2.1 (K), J1.5, R1.2, SW1.2, U6.22 (GPIO14/TOUCH14/ADC2_CH3/FSPIWP/FSPIDQS/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)
/plc4uni_top/RS485-RX: U6.12 (GPIO8/TOUCH8/ADC1_CH7/SUBSPICS1); also elsewhere on the board
/plc4uni_top/RS485-TX: U6.17 (GPIO9/TOUCH9/ADC1_CH8/FSPIHD/SUBSPIHD); also elsewhere on the board
/plc4uni_top/SD_CS: D6.1 (K), J1.3, U6.18 (GPIO10/TOUCH10/ADC1_CH9/FSPICS0/FSPIIO4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)
/plc4uni_top/SPI_CLK: D3.1 (K), J1.13, U6.20 (GPIO12/TOUCH12/ADC2_CH1/FSPICLK/FSPIIO6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); also elsewhere on the board
/plc4uni_top/SPI_MISO: D4.1 (K), J1.9, U6.21 (GPIO13/TOUCH13/ADC2_CH2/FSPIQ/FSPIIO7/S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); also elsewhere on the board
/plc4uni_top/SPI_MOSI: D5.1 (K), J1.11, U6.19 (GPIO11/TOUCH11/ADC2_CH0/FSPID/FSPIIO5/S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); also elsewhere on the board
/plc4uni_top/ST1_ST2: R6.1, R7.1, U6.32 (MTCK/GPIO39/CLK_OUT3/SUBSPICS1)
/plc4uni_top/TC_FAULT: U6.34 (MTDI/GPIO41/CLK_OUT1); also elsewhere on the board
/plc4uni_top/TEMP_CS: U6.25 (GPIO48/SPICLK_N/SUBSPICLK_N_DIFF); also elsewhere on the board
/plc4uni_top/TP_INT: J1.6, U6.33 (MTDO/GPIO40/CLK_OUT2)
/plc4uni_top/USB+: J1.14, U6.14 (GPIO20/U1CTS/ADC2_CH9/CLK_OUT1/USB_D+)
/plc4uni_top/USB-: J1.12, U6.13 (GPIO19/U1RTS/ADC2_CH8/CLK_OUT2/USB_D-)
GND: C1.2, C2.2, C3.2, C4.2, D1.2 (A), D2.2 (A), D3.2 (A), D4.2 (A), D5.2 (A), D6.2 (A), J1.15, J1.16, LED1.1 (K), SW1.1, SW2.1, U5.1 (ADDR), U5.3 (GND), U6.1 (GND), U6.40 (GND), U6.41 (GND); also elsewhere on the board
unnamed: LED1.2 (A), R4.2

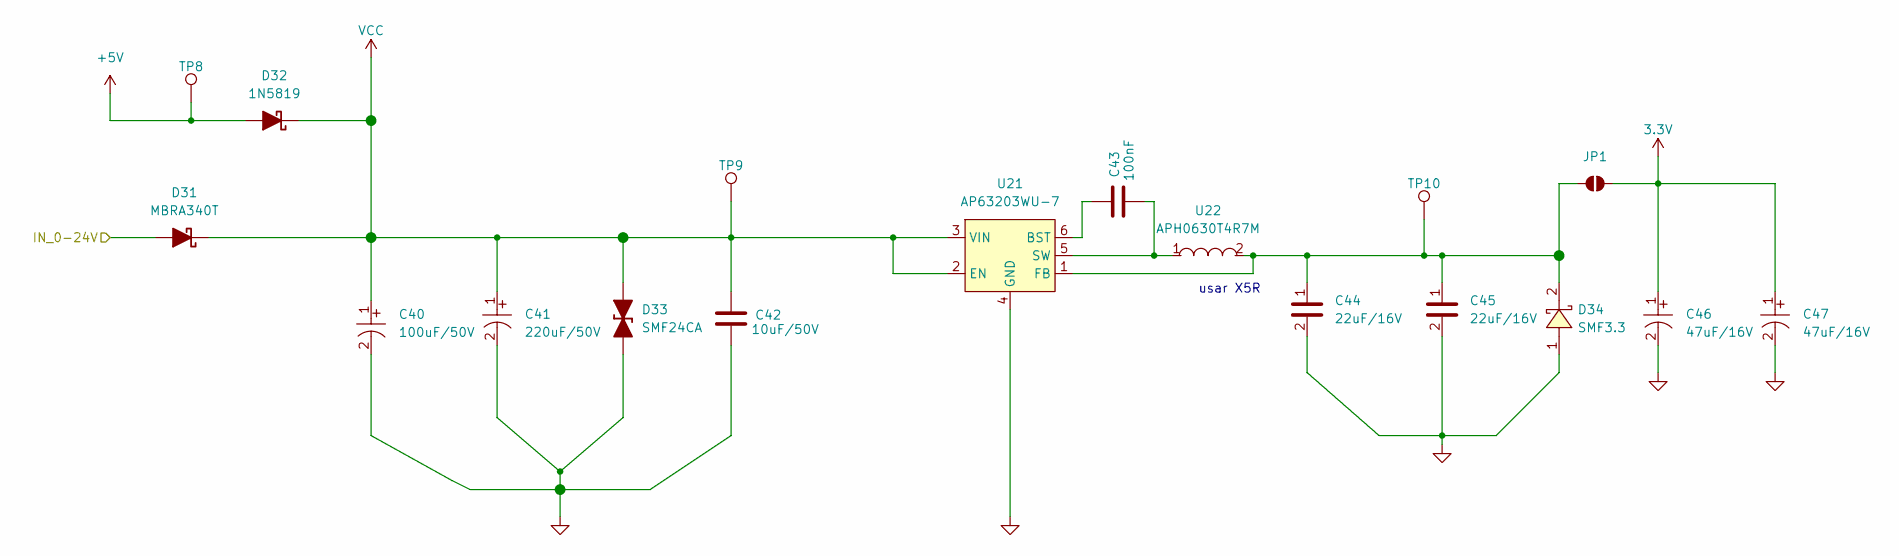
[picture p30: schematic PowerSupply.kicad_sch]

Parts:
C40: 100uF/50V; CAP-SMD_BD8.0-L8.3-W8.3-FD; MPN RVT1H101M0810; LCSC Part C72480
C41: 220uF/50V; CAP-SMD_BD10.0-L10.3-W10.3-LS11.3-FD; MPN UUD1H221MNL1GS; LCSC Part C125976
C42: 10uF/50V; C_0805_2012Metric; LCSC Part C440198
C43: 100nF; C_0805_2012Metric; LCSC Part C49678
C44, C45: 22uF/16V; C0805; MPN CL21A226MOQNNNE; LCSC Part C98190
C46, C47: 47uF/16V; CAP-SMD_BD6.3-L6.6-W6.6-FD; MPN UUD1C470MCL1GS; LCSC Part C340726
D31: MBRA340T; D_SMA
D32: 1N5819; D_DO-41_SOD81_P7.62mm_Horizontal
D33: SMF24CA; D_SOD-123F
D34: SMF3.3; SOD-123FL_L3.0-W1.9-LS3.7-FD; MPN SMF3.3; LCSC Part C2649858
JP1: Jumper_2_NO
TP8, TP9, TP10: 0.5mm; TestPoint-0.5mm
U21: AP63203WU-7; TSOT-26_L2.9-W1.6-P0.95-LS2.8-BL; MPN AP63203WU-7; LCSC Part C780769
U22: APH0630T4R7M; IND-SMD_L7.0-W6.6_APH0630; MPN APH0630T4R7M; LCSC Part C5349705

Connections:
3.3V: C46.1, C47.1, JP1.2 (B); also elsewhere on the board
+5V: D32.2 (A), TP8.1 (1_1); also elsewhere on the board
+24V: D31.2 (A); also elsewhere on the board
GND: C40.2, C41.2, C42.2, C44.2, C45.2, C46.2, C47.2, D33.1 (K), D34.1, U21.4 (GND); also elsewhere on the board
unnamed: C44.1, C45.1, D34.2, JP1.1 (A), TP10.1 (1_1), U21.1 (FB), U22.2
unnamed: C43.1, U21.6 (BST)
unnamed: C43.2, U21.5 (SW), U22.1
VCC: C40.1, C41.1, C42.1, D31.1 (K), D32.1 (K), D33.2 (A), TP9.1 (1_1), U21.2 (EN), U21.3 (VIN); also elsewhere on the board

Notes on the sheet:
usar X5R

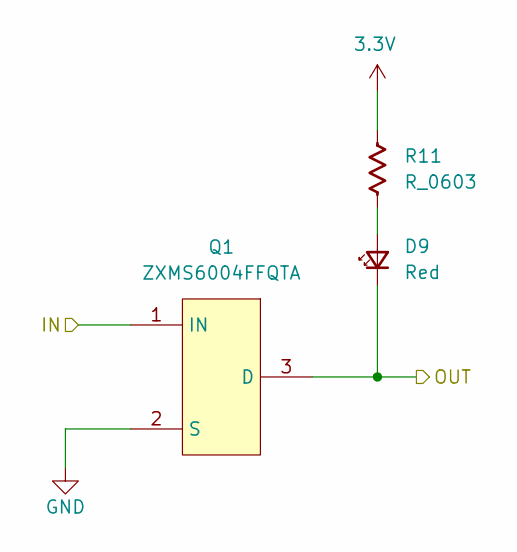
[picture p31: schematic OUT-NPN.kicad_sch]

Parts:
D9: Red; LED_0603_1608Metric_Red
Q1: ZXMS6004FFQTA; SOT-23F_L2.9-W1.8-P0.95-LS2.4-BR; MPN ZXMS6004FFQTA; LCSC Part C508259
R11: R_0603; R_0603_1608Metric

Connections:
3.3V: R11.1; also elsewhere on the board
/plc4uni_top/CON_OUT_NPN1: D9.1 (K), Q1.3 (D); also elsewhere on the board
/plc4uni_top/OUT_NPN1: Q1.1 (IN); also elsewhere on the board
GND: Q1.2 (S); also elsewhere on the board
unnamed: D9.2 (A), R11.2

Parts of its further copies:
D10, D11, D12: Red; LED_0603_1608Metric_Red
Q2, Q3, Q4: ZXMS6004FFQTA; SOT-23F_L2.9-W1.8-P0.95-LS2.4-BR; MPN ZXMS6004FFQTA; LCSC Part C508259
R12, R13, R14: R_0603; R_0603_1608Metric

Connections of its further copies:
3.3V: R12.1, R13.1, R14.1; also elsewhere on the board
/plc4uni_top/CON_OUT_NPN2: D10.1 (K), Q2.3 (D); also elsewhere on the board
/plc4uni_top/CON_OUT_NPN3: D11.1 (K), Q3.3 (D); also elsewhere on the board
/plc4uni_top/CON_OUT_NPN4: D12.1 (K), Q4.3 (D); also elsewhere on the board
/plc4uni_top/OUT_NPN2: Q2.1 (IN); also elsewhere on the board
/plc4uni_top/OUT_NPN3: Q3.1 (IN); also elsewhere on the board
/plc4uni_top/OUT_NPN4: Q4.1 (IN); also elsewhere on the board
GND: Q2.2 (S), Q3.2 (S), Q4.2 (S); also elsewhere on the board
unnamed: D10.2 (A), R12.2
unnamed: D11.2 (A), R13.2
unnamed: D12.2 (A), R14.2

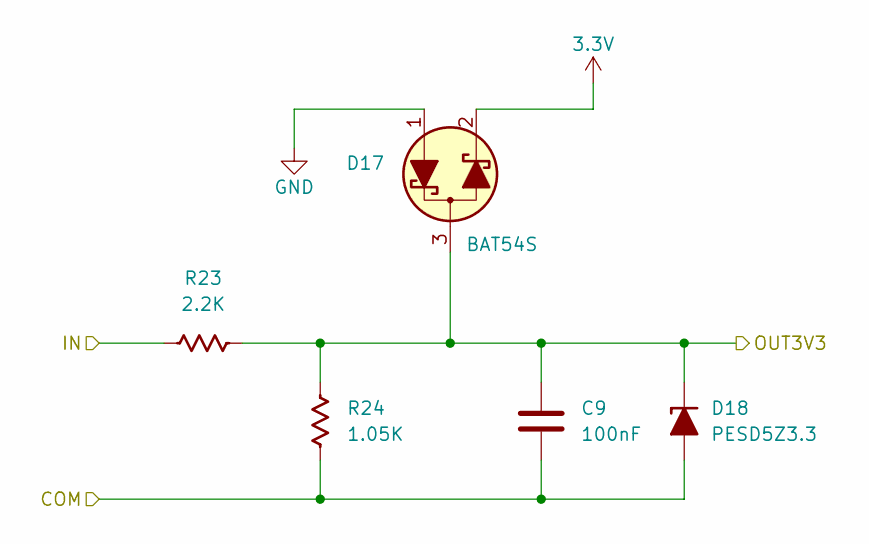
[picture p32: schematic IN-0-10V.kicad_sch]

Parts:
C9: 100nF; C_0603_1608Metric
D17: BAT54S; SOT-23
D18: PESD5Z3.3; D_SOD-523
R23: 2.2K; R_0603_1608Metric
R24: 1.05K; R_0603_1608Metric

Connections:
3.3V: D17.2 (K); also elsewhere on the board
/plc4uni_top/CON_IN_0-10V_1: R23.1; also elsewhere on the board
/plc4uni_top/IN-0-10V/COM: C9.2, D18.2 (A), R24.1
/plc4uni_top/IN-0-10V/OUT3V3: C9.1, D17.3 (C), D18.1 (K), R23.2, R24.2; also elsewhere on the board
GND: D17.1 (A); also elsewhere on the board

Parts of its further copies:
C10: 100nF; C_0603_1608Metric
D19: BAT54S; SOT-23
D20: PESD5Z3.3; D_SOD-523
R25: 2.2K; R_0603_1608Metric
R26: 1.05K; R_0603_1608Metric

Connections of its further copies:
3.3V: D19.2 (K); also elsewhere on the board
/plc4uni_top/CON_IN_0-10V_2: R25.1; also elsewhere on the board
/plc4uni_top/IN-0-10V1/COM: C10.2, D20.2 (A), R26.1
/plc4uni_top/IN-0-10V1/OUT3V3: C10.1, D19.3 (C), D20.1 (K), R25.2, R26.2; also elsewhere on the board
GND: D19.1 (A); also elsewhere on the board

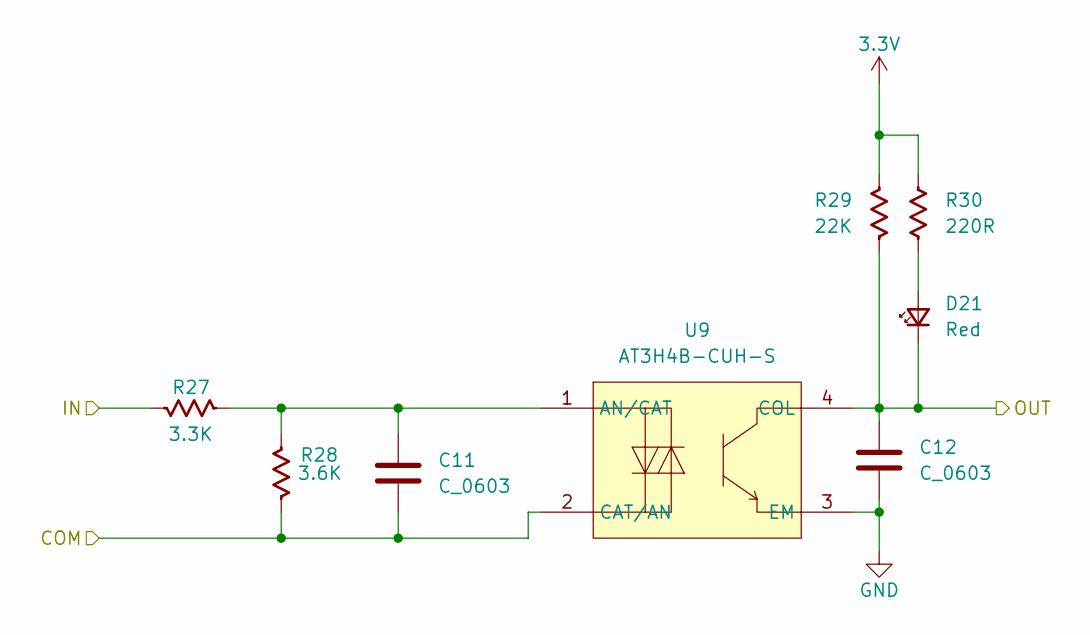
[picture p33: schematic IN-DI.kicad_sch]

Parts:
C11, C12: C_0603; C_0603_1608Metric
D21: Red; LED_0603_1608Metric_Red
R27: 3.3K; R_0603_1608Metric
R28: 3.6K; R_0603_1608Metric
R29: 22K; R_0603_1608Metric
R30: 220R; R_0603_1608Metric
U9: AT3H4B-CUH-S; SSOP-4_L2.7-W4.6-P1.27-LS7.0-TL; MPN AT3H4B-CuH-S; LCSC Part C20612635

Connections:
3.3V: R29.2, R30.2; also elsewhere on the board
/plc4uni_top/CON_IN_NPN1: R27.2; also elsewhere on the board
/plc4uni_top/IN_NPN1: C12.1, D21.1 (K), R29.1, U9.4 (COL); also elsewhere on the board
GND: C12.2, U9.3 (EM); also elsewhere on the board
unnamed: D21.2 (A), R30.1
unnamed: C11.1, R27.1, R28.1, U9.1 (AN/CAT)
VCC: C11.2, R28.2, U9.2 (CAT/AN); also elsewhere on the board

Parts of its further copies:
C13, C14, C15, C16, C17, C18, C19, C20, C21, C22: C_0603; C_0603_1608Metric
D22, D23, D24, D25, D26: Red; LED_0603_1608Metric_Red
R31, R35, R39, R43, R47: 3.3K; R_0603_1608Metric
R32, R36, R40, R44, R48: 3.6K; R_0603_1608Metric
R33, R37, R41, R45, R49: 22K; R_0603_1608Metric
R34, R38, R42, R46, R50: 220R; R_0603_1608Metric
U10, U11, U12, U13, U14: AT3H4B-CUH-S; SSOP-4_L2.7-W4.6-P1.27-LS7.0-TL; MPN AT3H4B-CuH-S; LCSC Part C20612635

Connections of its further copies:
3.3V: R33.2, R34.2, R37.2, R38.2, R41.2, R42.2, R45.2, R46.2, R49.2, R50.2; also elsewhere on the board
/plc4uni_top/CON_IN_NPN2: R31.2; also elsewhere on the board
/plc4uni_top/CON_IN_NPN3: R35.2; also elsewhere on the board
/plc4uni_top/CON_IN_NPN4: R39.2; also elsewhere on the board
/plc4uni_top/CON_IN_PNP1: R43.2; also elsewhere on the board
/plc4uni_top/CON_IN_PNP2: R47.2; also elsewhere on the board
/plc4uni_top/IN_NPN2: C14.1, D22.1 (K), R33.1, U10.4 (COL); also elsewhere on the board
/plc4uni_top/IN_NPN3: C16.1, D23.1 (K), R37.1, U11.4 (COL); also elsewhere on the board
/plc4uni_top/IN_NPN4: C18.1, D24.1 (K), R41.1, U12.4 (COL); also elsewhere on the board
/plc4uni_top/IN_PNP1: C20.1, D25.1 (K), R45.1, U13.4 (COL); also elsewhere on the board
/plc4uni_top/IN_PNP2: C22.1, D26.1 (K), R49.1, U14.4 (COL); also elsewhere on the board
GND: C14.2, C16.2, C18.2, C19.2, C20.2, C21.2, C22.2, R44.2, R48.2, U10.3 (EM), U11.3 (EM), U12.3 (EM), U13.2 (CAT/AN), U13.3 (EM), U14.2 (CAT/AN), U14.3 (EM); also elsewhere on the board
unnamed: D22.2 (A), R34.1
unnamed: D23.2 (A), R38.1
unnamed: D24.2 (A), R42.1
unnamed: D25.2 (A), R46.1
unnamed: D26.2 (A), R50.1
unnamed: C13.1, R31.1, R32.1, U10.1 (AN/CAT)
unnamed: C15.1, R35.1, R36.1, U11.1 (AN/CAT)
unnamed: C17.1, R39.1, R40.1, U12.1 (AN/CAT)
unnamed: C19.1, R43.1, R44.1, U13.1 (AN/CAT)
unnamed: C21.1, R47.1, R48.1, U14.1 (AN/CAT)
VCC: C13.2, C15.2, C17.2, R32.2, R36.2, R40.2, U10.2 (CAT/AN), U11.2 (CAT/AN), U12.2 (CAT/AN); also elsewhere on the board

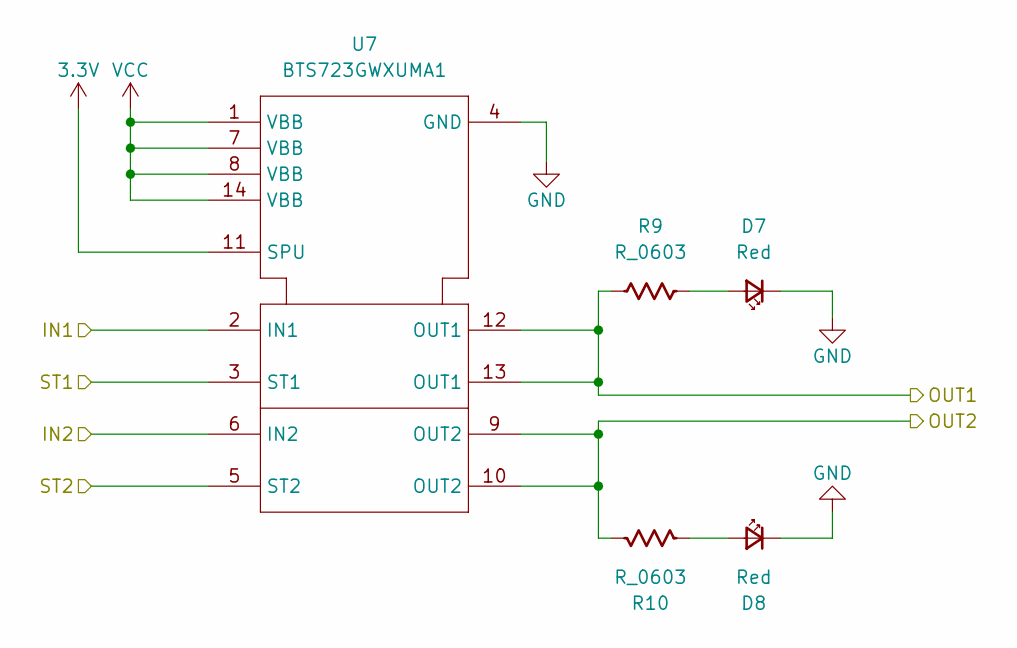
[picture p34: schematic OUT-PNP.kicad_sch]

Parts:
D7, D8: Red; LED_0603_1608Metric_Red
R9, R10: R_0603; R_0603_1608Metric
U7: BTS723GWXUMA1; SOIC-14_L8.7-W3.9-P1.27-LS6.0-BL; MPN BTS723GW; LCSC Part C67625

Connections:
3.3V: U7.11 (SPU); also elsewhere on the board
/plc4uni_top/CON_OUT_PNP1: R9.1, U7.12 (OUT1), U7.13 (OUT1); also elsewhere on the board
/plc4uni_top/CON_OUT_PNP2: R10.1, U7.9 (OUT2), U7.10 (OUT2); also elsewhere on the board
/plc4uni_top/OUT-PNP/ST1: U7.3 (ST1); also elsewhere on the board
/plc4uni_top/OUT-PNP/ST2: U7.5 (ST2); also elsewhere on the board
/plc4uni_top/OUT_PNP1: U7.2 (IN1); also elsewhere on the board
/plc4uni_top/OUT_PNP2: U7.6 (IN2); also elsewhere on the board
GND: D7.1 (K), D8.1 (K), U7.4 (GND); also elsewhere on the board
unnamed: D7.2 (A), R9.2
unnamed: D8.2 (A), R10.2
VCC: U7.1 (VBB), U7.7 (VBB), U7.8 (VBB), U7.14 (VBB); also elsewhere on the board

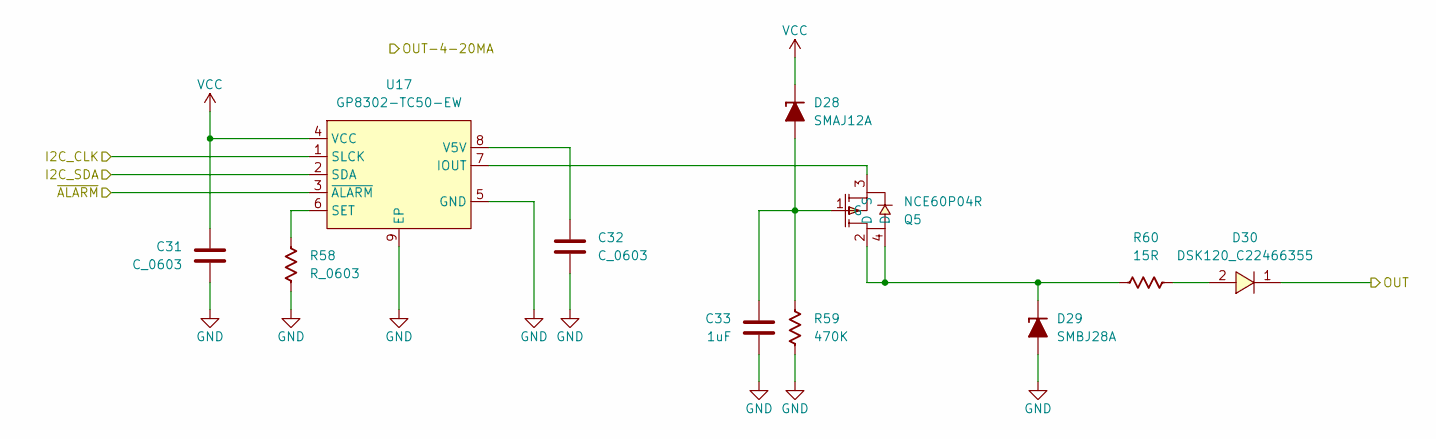
[picture p35: schematic OUT-4-20MA.kicad_sch]

Parts:
C31, C32: C_0603; C_0603_1608Metric
C33: 1uF; C_0603_1608Metric
D28: SMAJ12A; D_SMA
D29: SMBJ28A; D_SMB
D30: DSK120_C22466355; SOD-123FL_L2.7-W1.8-LS3.8-RD; MPN DSK120; LCSC Part C22466355
Q5: NCE60P04R; SOT-223-3_L6.5-W3.4-P2.30-LS7.0-BR; MPN NCE60P04R; LCSC Part C502855
R58: R_0603; R_0603_1608Metric
R59: 470K; R_0603_1608Metric
R60: 15R; R_0805_2012Metric
U17: GP8302-TC50-EW; ESOP-8_L4.9-W3.9-P1.27-LS6.0-BL-EP; MPN GP8302-TC50-EW; LCSC Part C2856295

Connections:
/plc4uni_top/CON_OUT_4-20MA_1: D30.1; also elsewhere on the board
/plc4uni_top/I2C_SCK: U17.1 (SLCK); also elsewhere on the board
/plc4uni_top/I2C_SDA: U17.2 (SDA); also elsewhere on the board
/plc4uni_top/OUT-4-20MA/~ALARM: U17.3 (~ALARM)
GND: C31.2, C32.2, C33.2, D29.2 (A), R58.2, R59.2, U17.5 (GND), U17.9 (EP); also elsewhere on the board
unnamed: C33.1, D28.2 (A), Q5.1 (G), R59.1
unnamed: D29.1 (K), Q5.2 (D), Q5.4 (D), R60.2
unnamed: D30.2, R60.1
unnamed: Q5.3 (S), U17.7 (IOUT)
unnamed: R58.1, U17.6 (SET)
unnamed: C32.1, U17.8 (V5V)
VCC: C31.1, D28.1 (K), U17.4 (VCC); also elsewhere on the board
