0sirys/Juan_Pimentel_Electiva_2026_C2/PCB/PLC4UNI/_restore_backup_2026-08-12T22-09-03-060/PLC4UNI.kicad_pcb

## KiCad design PCB/PLC4UNI/_restore_backup_2026-08-12T22-09-03-060/PLC4UNI.kicad_pcb (continued)

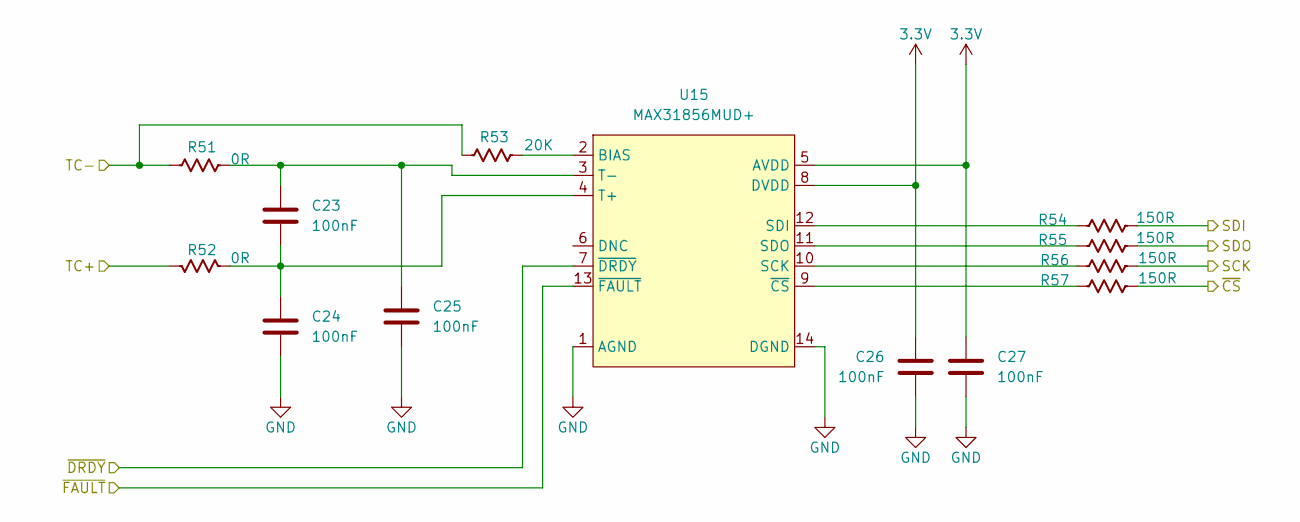
[picture p36: schematic TC.kicad_sch]

Parts:
C23, C24, C25, C26, C27: 100nF; C_0603_1608Metric
R51, R52: 0R; R_0603_1608Metric
R53: 20K; R_0603_1608Metric
R54, R55, R56, R57: 150R; R_0603_1608Metric
U15: MAX31856MUD+; TSSOP-14_L5.0-W4.4-P0.65-LS6.4-BL; MPN MAX31856MUD+; LCSC Part C116632

Connections:
3.3V: C26.1, C27.1, U15.5 (AVDD), U15.8 (DVDD); also elsewhere on the board
/plc4uni_top/CON_IN_TC+: R52.2; also elsewhere on the board
/plc4uni_top/CON_IN_TC-: R51.1, R53.1; also elsewhere on the board
/plc4uni_top/SPI_CLK: R56.2; also elsewhere on the board
/plc4uni_top/SPI_MISO: R55.2; also elsewhere on the board
/plc4uni_top/SPI_MOSI: R54.2; also elsewhere on the board
/plc4uni_top/TC/~DRDY: U15.7 (~DRDY)
/plc4uni_top/TC_FAULT: U15.13 (~FAULT); also elsewhere on the board
/plc4uni_top/TEMP_CS: R57.2; also elsewhere on the board
GND: C24.2, C25.2, C26.2, C27.2, U15.1 (AGND), U15.14 (DGND); also elsewhere on the board
unnamed: R53.2, U15.2 (BIAS)
unnamed: R56.1, U15.10 (SCK)
unnamed: R54.1, U15.12 (SDI)
unnamed: R55.1, U15.11 (SDO)
unnamed: C23.2, C24.1, R52.1, U15.4 (T+)
unnamed: C23.1, C25.1, R51.2, U15.3 (T-)
unnamed: R57.1, U15.9 (~CS)

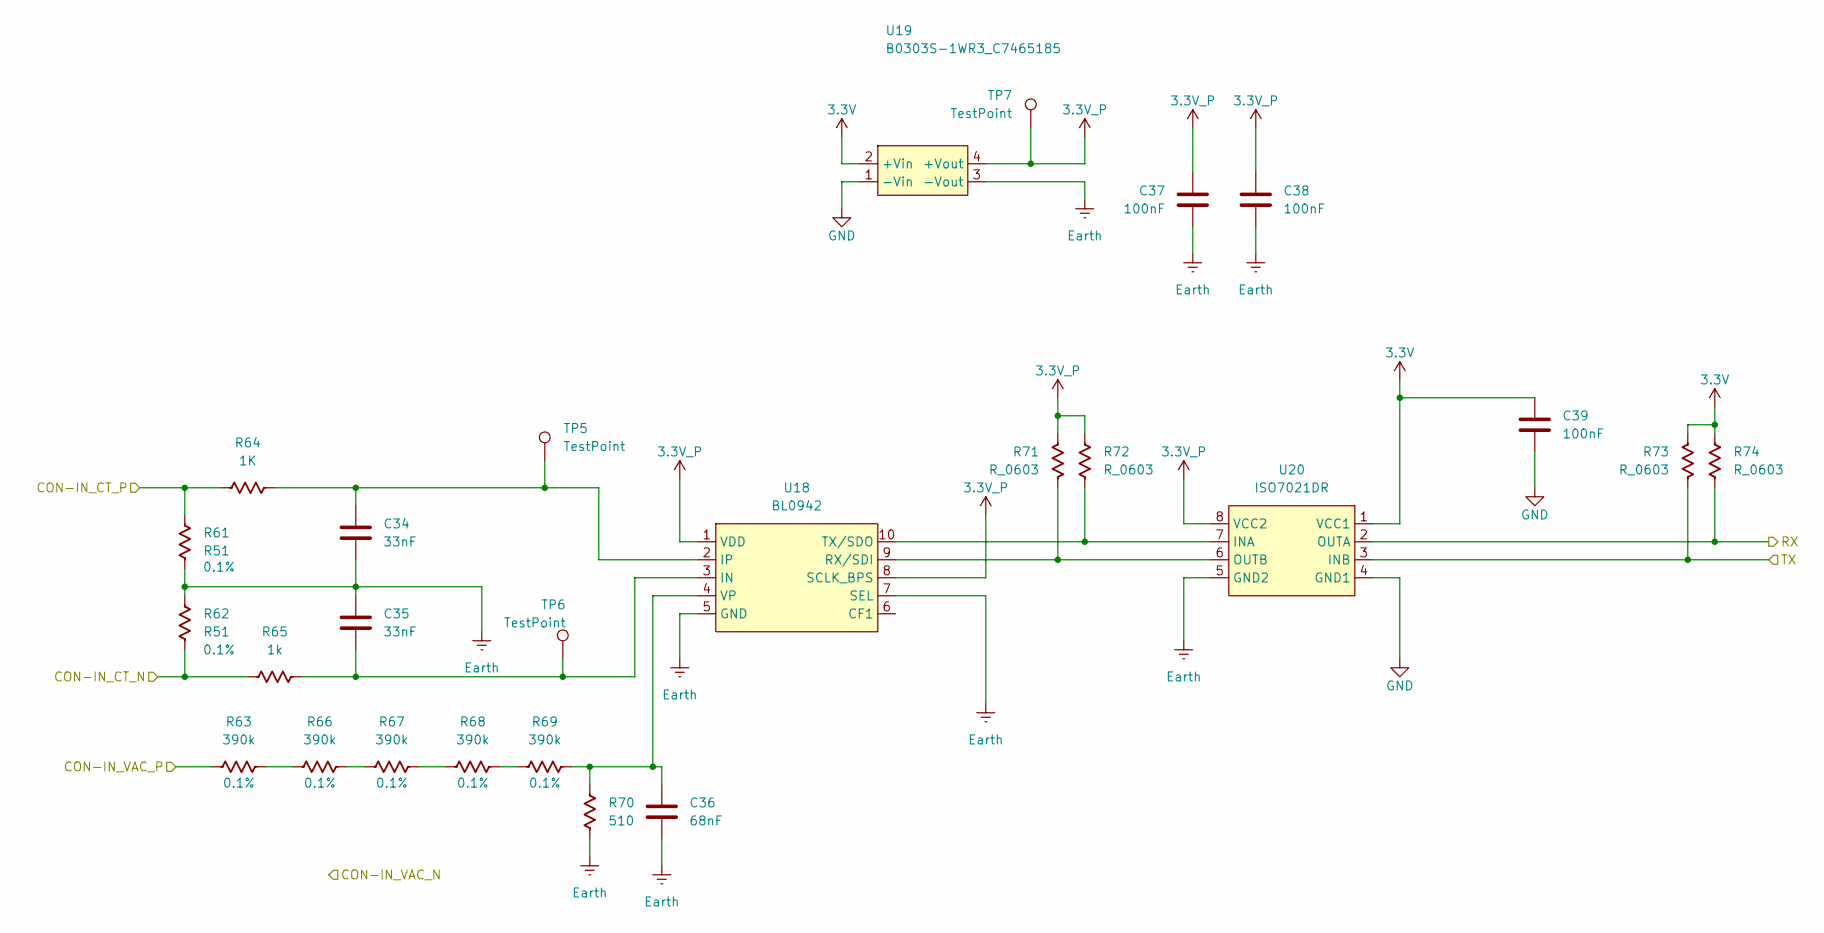
[picture p37: schematic ENERGY-METER.kicad_sch]

Parts:
C34, C35: 33nF; C_0603_1608Metric
C36: 68nF; C_0603_1608Metric
C37, C38, C39: 100nF; C_0603_1608Metric
R61, R62: R51; R_0805_2012Metric
R63, R66, R67, R68, R69: 390k; R_0603_1608Metric
R64: 1K; R_0603_1608Metric
R65: 1k; R_0603_1608Metric
R70: 510; R_0603_1608Metric
R71, R72, R73, R74: R_0603; R_0603_1608Metric
TP5, TP6, TP7: TestPoint; TestPoint_THTPad_D1.5mm_Drill0.7mm
U18: BL0942; SSOP-10_L4.9-W3.9-P1.00-LS6.0-BL; MPN BL0942; LCSC Part C2837510
U19: B0303S-1WR3_C7465185; PWRM-TH_BXXXXS-1WR3; MPN B0303S-1WR3; LCSC Part C7465185
U20: ISO7021DR; SOIC-8_L4.9-W3.9-P1.27-LS6.0-BL; MPN ISO7021DR; LCSC Part C2867957

Connections:
3.3V: C39.1, R73.1, R74.1, U19.2 (+Vin), U20.1 (VCC1); also elsewhere on the board
3.3V_P: C37.1, C38.1, R71.1, R72.1, TP7.1 (1_1), U18.1 (VDD), U18.8 (SCLK_BPS), U19.4 (+Vout), U20.8 (VCC2)
/plc4uni_top/CON-IN_CT_N: R62.2, R65.1; also elsewhere on the board
/plc4uni_top/CON-IN_CT_P: R61.1, R64.1; also elsewhere on the board
/plc4uni_top/CON_IN_VAC-P: R63.1; also elsewhere on the board
/plc4uni_top/EMRX: R73.2, U20.3 (INB); also elsewhere on the board
/plc4uni_top/EM_TX: R74.2, U20.2 (OUTA); also elsewhere on the board
Earth: C34.2, C35.1, C36.2, C37.2, C38.2, R61.2, R62.1, R70.1, U18.5 (GND), U18.7 (SEL), U19.3 (-Vout), U20.5 (GND2); also elsewhere on the board
GND: C39.2, U19.1 (-Vin), U20.4 (GND1); also elsewhere on the board
unnamed: R63.2, R66.1
unnamed: R66.2, R67.1
unnamed: R67.2, R68.1
unnamed: R68.2, R69.1
unnamed: C35.2, R65.2, TP6.1 (1_1), U18.3 (IN)
unnamed: C34.1, R64.2, TP5.1 (1_1), U18.2 (IP)
unnamed: R71.2, U18.9 (RX/SDI), U20.6 (OUTB)
unnamed: R72.2, U18.10 (TX/SDO), U20.7 (INA)
unnamed: C36.1, R69.2, R70.2, U18.4 (VP)

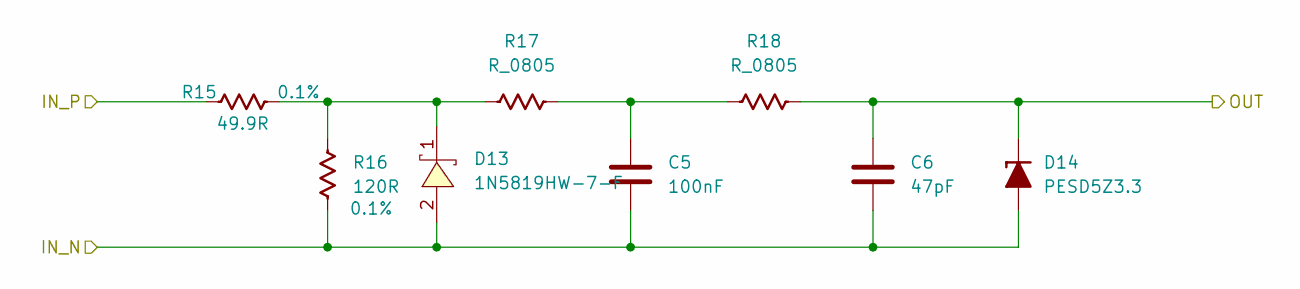
[picture p38: schematic IN-4-20MA.kicad_sch]

Parts:
C5: 100nF; TestPoint_THTPad_D1.5mm_Drill0.7mm
C6: 47pF; C_0603_1608Metric
D13: 1N5819HW-7-F; SOD-123_L2.7-W1.6-LS3.7-RD; MPN 1N5819HW-7-F; LCSC Part C82544
D14: PESD5Z3.3; D_SOD-523
R15: 49.9R; R_0805_2012Metric; Tolerancia 0.1%
R16: 120R; R_0805_2012Metric; Tolerancia 0.1%
R17, R18: R_0805; R_0805_2012Metric

Connections:
/plc4uni_top/CON_IN_4-20MA_1: R15.1; also elsewhere on the board
/plc4uni_top/IN-4-20MA/OUT: C6.1, D14.1 (K), R18.2; also elsewhere on the board
GND: C5.2, C6.2, D13.2, D14.2 (A), R16.1; also elsewhere on the board
unnamed: C5.1, R17.2, R18.1
unnamed: D13.1, R15.2, R16.2, R17.1

Parts of its further copies:
C7: 100nF; TestPoint_THTPad_D1.5mm_Drill0.7mm
C8: 47pF; C_0603_1608Metric
D15: 1N5819HW-7-F; SOD-123_L2.7-W1.6-LS3.7-RD; MPN 1N5819HW-7-F; LCSC Part C82544
D16: PESD5Z3.3; D_SOD-523
R19: 49.9R; R_0805_2012Metric; Tolerancia 0.1%
R20: 120R; R_0805_2012Metric; Tolerancia 0.1%
R21, R22: R_0805; R_0805_2012Metric

Connections of its further copies:
/plc4uni_top/CON_IN_4-20MA_2: R19.1; also elsewhere on the board
/plc4uni_top/IN-4-20MA1/OUT: C8.1, D16.1 (K), R22.2; also elsewhere on the board
GND: C8.2, D15.2, D16.2 (A), R20.1; also elsewhere on the board
unnamed: C7.1, R21.2, R22.1
unnamed: D15.1, R19.2, R20.2, R21.1

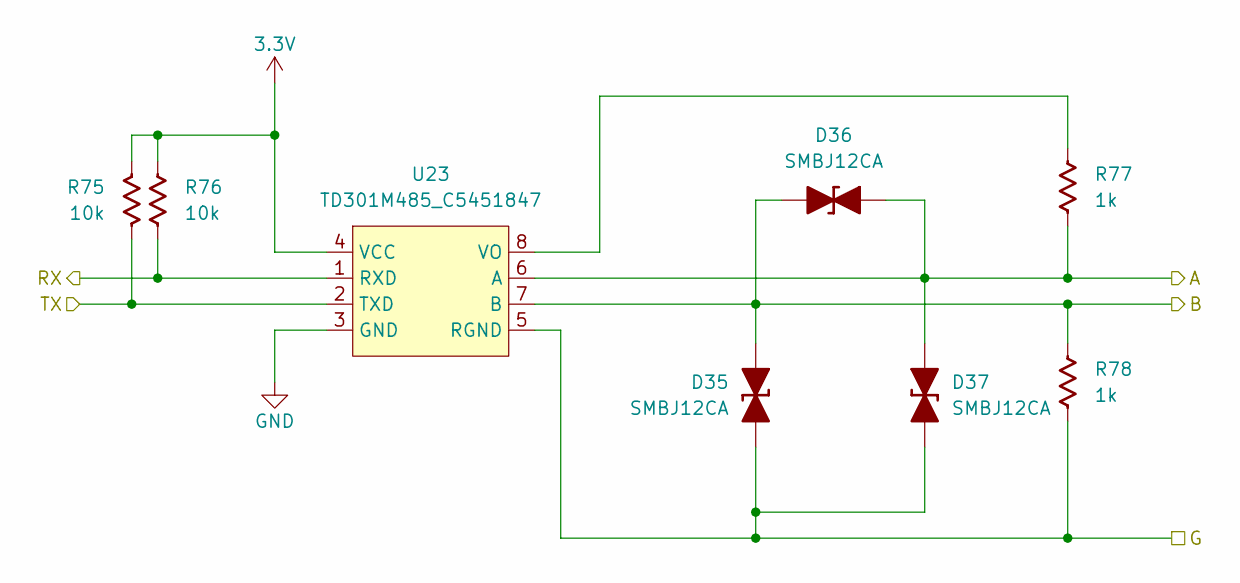
[picture p39: schematic RS485.kicad_sch]

Parts:
D35, D36, D37: SMBJ12CA; D_SMB_TVS
R75, R76: 10k; R_0603_1608Metric
R77, R78: 1k; R_0603_1608Metric
U23: TD301M485_C5451847; COMM-TH_TD301M485; MPN TD301M485; LCSC Part C5451847

Connections:
3.3V: R75.1, R76.1, U23.4 (VCC); also elsewhere on the board
/plc4uni_top/CON_RS485_A: D35.2 (A), D36.1 (K), R78.1, U23.7 (B); also elsewhere on the board
/plc4uni_top/CON_RS485_B: D36.2 (A), D37.2 (A), R77.2, U23.6 (A); also elsewhere on the board
/plc4uni_top/CON_RS485_G: D35.1 (K), D37.1 (K), R78.2, U23.5 (RGND); also elsewhere on the board
/plc4uni_top/RS485-RX: R76.2, U23.1 (RXD); also elsewhere on the board
/plc4uni_top/RS485-TX: R75.2, U23.2 (TXD); also elsewhere on the board
GND: U23.3 (GND); also elsewhere on the board
unnamed: R77.1, U23.8 (VO)

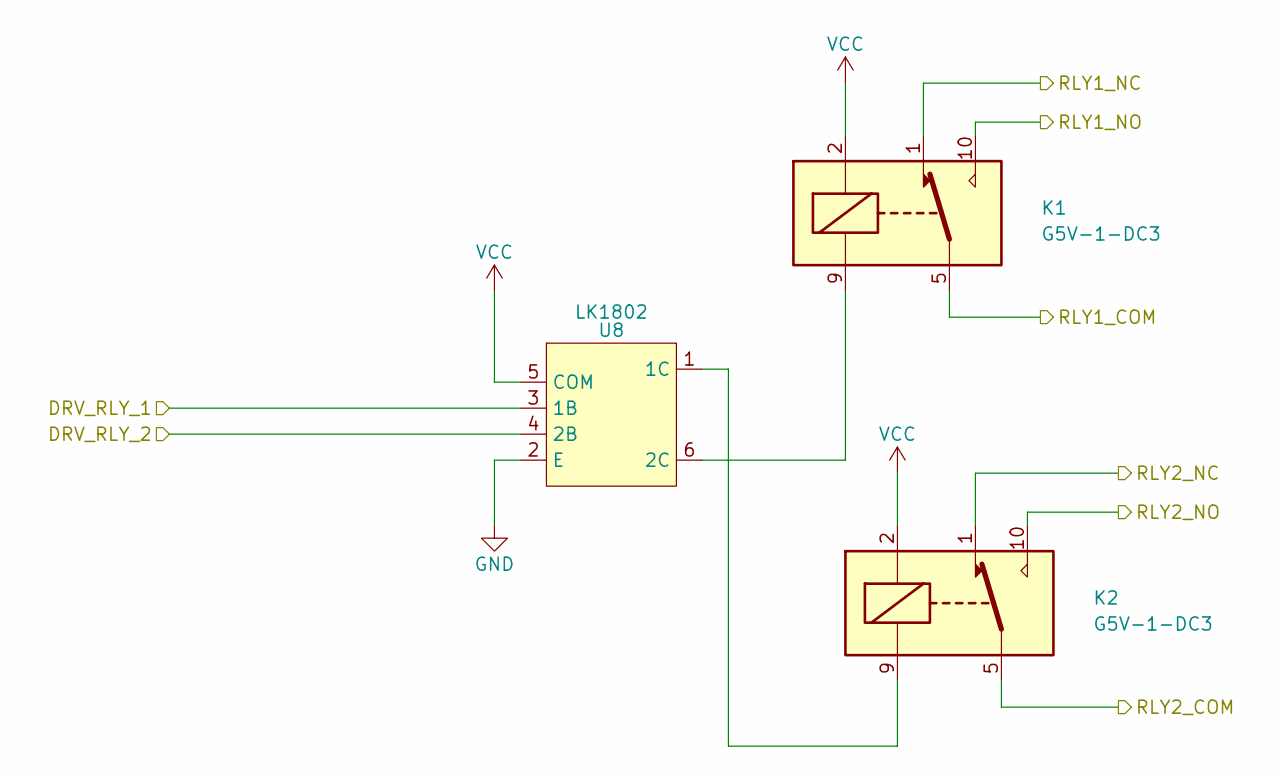
[picture p40: schematic TLY.kicad_sch]

Parts:
K1, K2: G5V-1-DC3; RELAY-TH_G5V-1; MPN G5V-1 DC3; LCSC Part C397232
U8: LK1802; SOT-23-6_L2.9-W1.6-P0.95-LS2.8-BR; MPN LK1802; LCSC Part C2984831

Connections:
/plc4uni_top/CON_OUT_RLY1-COM: K1.5; also elsewhere on the board
/plc4uni_top/CON_OUT_RLY1-NC: K1.1; also elsewhere on the board
/plc4uni_top/CON_OUT_RLY1-NO: K1.10; also elsewhere on the board
/plc4uni_top/CON_OUT_RLY2-COM: K2.5; also elsewhere on the board
/plc4uni_top/CON_OUT_RLY2-NC: K2.1; also elsewhere on the board
/plc4uni_top/CON_OUT_RLY2-NO: K2.10; also elsewhere on the board
/plc4uni_top/OUT_RLY1: U8.3 (1B); also elsewhere on the board
/plc4uni_top/OUT_RLY2: U8.4 (2B); also elsewhere on the board
GND: U8.2 (E); also elsewhere on the board
unnamed: K2.9, U8.1 (1C)
unnamed: K1.9, U8.6 (2C)
VCC: K1.2, K2.2, U8.5 (COM); also elsewhere on the board

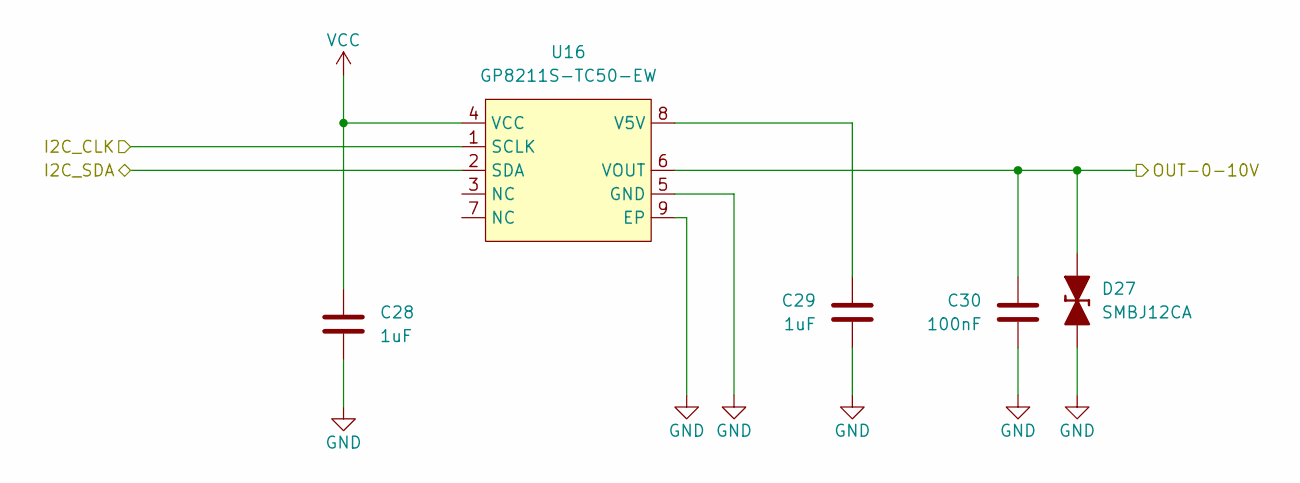
[picture p41: schematic 0UT-0-10V.kicad_sch]

Parts:
C28, C29: 1uF; C_0603_1608Metric
C30: 100nF; C_0603_1608Metric
D27: SMBJ12CA; D_SMB_TVS
U16: GP8211S-TC50-EW; ESOP-8_L4.9-W3.9-P1.27-LS6.0-BL-EP; MPN GP8211S-TC50-EW; LCSC Part C3152008

Connections:
/plc4uni_top/CON_OUT_0-10V_1: C30.1, D27.2 (A), U16.6 (VOUT); also elsewhere on the board
/plc4uni_top/I2C_SCK: U16.1 (SCLK); also elsewhere on the board
/plc4uni_top/I2C_SDA: U16.2 (SDA); also elsewhere on the board
GND: C28.2, C29.2, C30.2, D27.1 (K), U16.5 (GND), U16.9 (EP); also elsewhere on the board
unnamed: C29.1, U16.8 (V5V)
VCC: C28.1, U16.4 (VCC); also elsewhere on the board

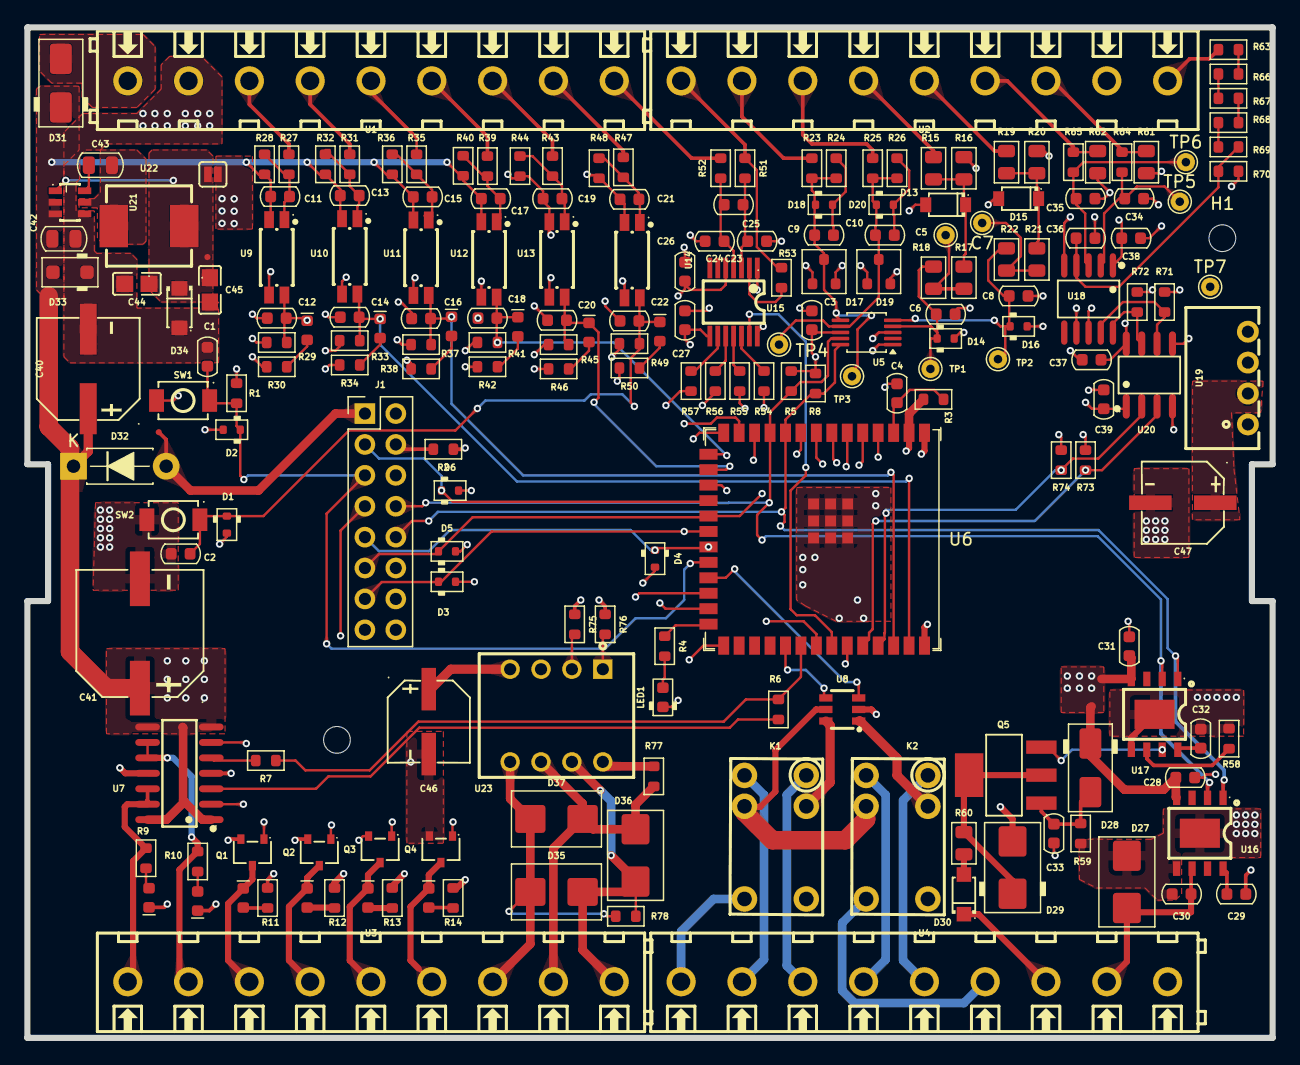
[picture p42: board PLC4UNI.kicad_pcb from above]

Board: 4 copper layers, 102.4 x 83.1 mm, 209 parts (0 on the bottom side), 134 nets.
