0sirys/Juan_Pimentel_Electiva_2026_C2/(commit log)

2026-06-11 Tarea 2 Done
    [Ejercicio_1.FCStd, Ejercicio_2.FCStd]
2026-06-18 Tarea3 realizada
    [0UT-0-10V.kicad_sch, ENERGY-METER.kicad_sch, IN-0-10V.kicad_sch, IN-4-20MA.kicad_sch, IN-DI.kicad_sch, IN_NPN.kicad_sch, OUT-4-20MA.kicad_sch, PLC4UNI.kicad_pcb]
2026-06-18 Agregar salidas
    [OUT_NPN.kicad_sch, OUT_PNP.kicad_sch]
2026-06-18 Assembly Tarea 2
    [Ejercicio_2.FCStd]
2026-07-04 Cambio de directorio [Tarea2->CAD]
    [0UT-0-10V.kicad_sch, ENERGY-METER.kicad_sch, Ejercicio_1.FCStd, Ejercicio_2.FCStd, IN-0-10V.kicad_sch, IN-4-20MA.kicad_sch, OUT-4-20MA.kicad_sch, OUT-NPN.kicad_sch]
2026-07-04 Cambio de directorio [Tarea3->PCB]
    [0UT-0-10V.kicad_sch, ENERGY-METER.kicad_sch, IN-0-10V.kicad_sch, IN-4-20MA.kicad_sch, IN-DI.kicad_sch, IN_NPN.kicad_sch, OUT-4-20MA.kicad_sch, OUT-NPN.kicad_sch]
2026-07-04 borrar Tarea3/ & Tarea2/
    [0UT-0-10V.kicad_sch, ENERGY-METER.kicad_sch, Ejercicio_1.FCStd, Ejercicio_2.FCStd, IN-0-10V.kicad_sch, IN-4-20MA.kicad_sch, IN-DI.kicad_sch, IN_NPN.kicad_sch]
2026-07-14 add ruteo buck-converter, inputs pnp,npn
    [0UT-0-10V.kicad_sch, ENERGY-METER.kicad_sch, IN-0-10V.kicad_sch, IN-4-20MA.kicad_sch, IN-DI.kicad_sch, OUT-4-20MA.kicad_sch, OUT-NPN.kicad_sch, OUT-PNP.kicad_sch]
2026-07-14 0-10V input, 4-20mA input
    [0UT-0-10V.kicad_sch, ENERGY-METER.kicad_sch, IN-0-10V.kicad_sch, IN-4-20MA.kicad_sch, IN-DI.kicad_sch, OUT-4-20MA.kicad_sch, OUT-NPN.kicad_sch, OUT-PNP.kicad_sch]
2026-07-15 power supply and inputs routed
    [ENERGY-METER.kicad_sch, IN-4-20MA.kicad_sch, PLC4UNI.kicad_pcb, PLC4UNI.kicad_sch, plcuni_top.kicad_sch]
2026-07-16 ruteo terminado
    [PLC4UNI.kicad_pcb, TLY.kicad_sch, plcuni_top.kicad_sch]
2026-07-16 add teardrops
    [PLC4UNI.kicad_pcb, PowerSupply.kicad_sch]
2026-07-17 add mezzanini pcb
    [PLC4UNI.kicad_pcb, PLC4UNI_MEZANINI.kicad_pcb, PLC4UNI_MEZANINI.kicad_sch, plcuni_top.kicad_sch]
2026-07-18 Ruteo MEZZANINI
    [PLC4UNI_MEZANINI.kicad_pcb, bom.csv, designators.csv, positions.csv]
2026-08-13 ajuste de dimenciones
    [PLC4UNI_MEZANINI.kicad_pcb]
2026-08-13 ensamblado en proceso
    [PLC4UNI.kicad_pcb, PLC4UNI_MEZANINI.kicad_pcb]
